austiz/Hovercraft/51o7EGVD7rL._SX522_.jpg

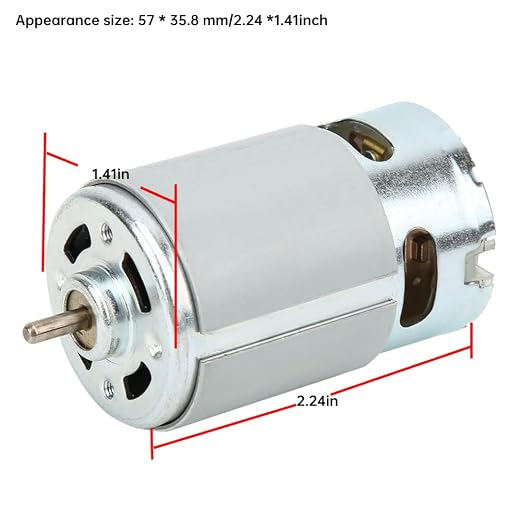
51o7EGVD7rL._SX522_.jpg
