austiz/Hovercraft/mockup/05_fan_closeup.png

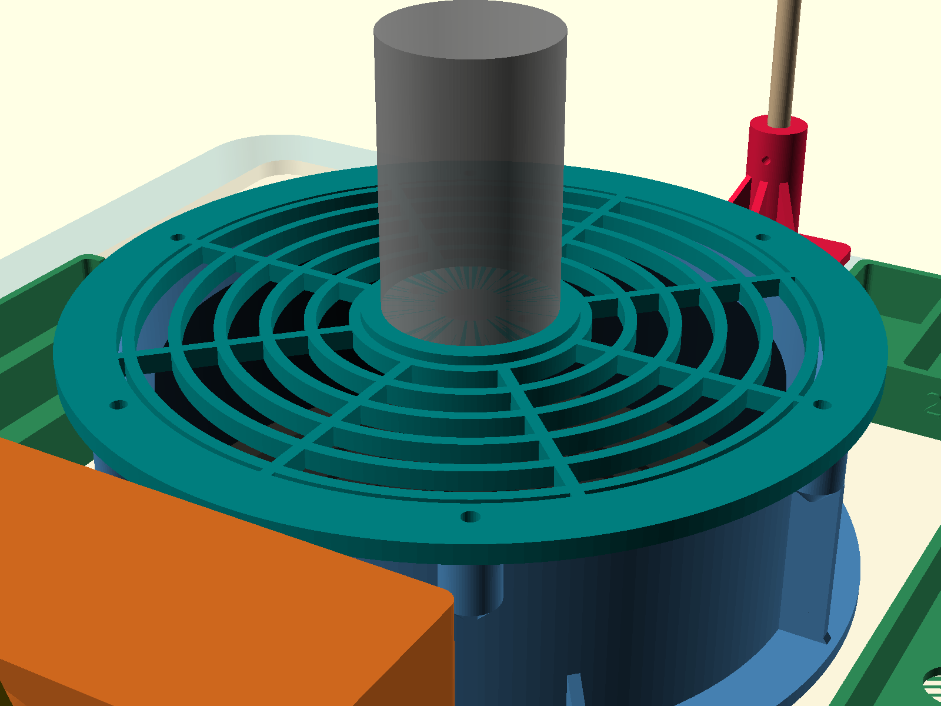
mockup/05_fan_closeup.png
