austiz/Hovercraft/mockup/01_iso_front.png

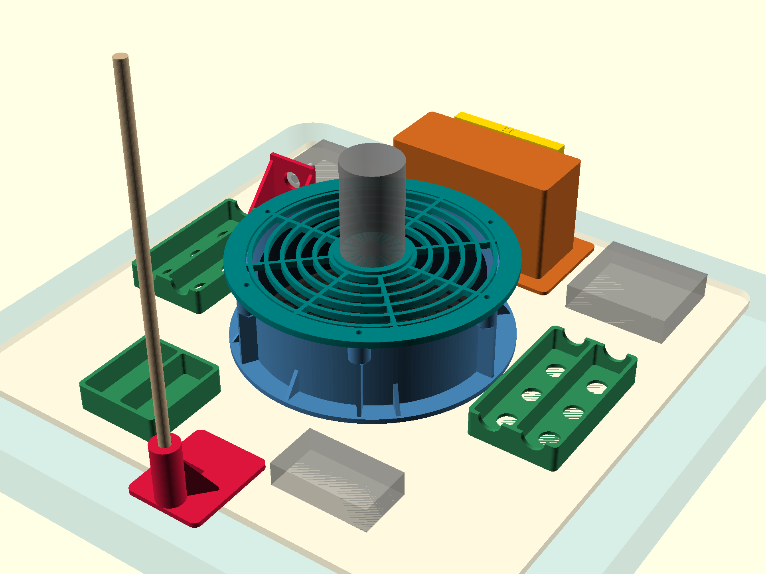
mockup/01_iso_front.png
