austiz/Hovercraft/mockup/02_iso_rear.png

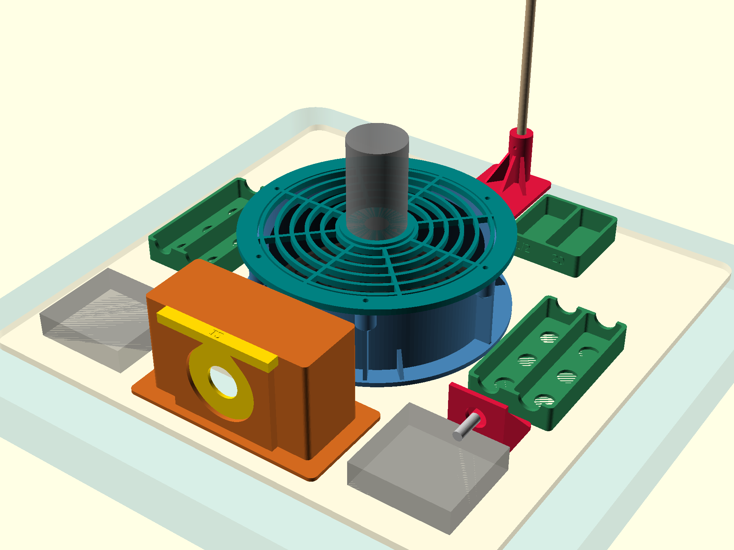
mockup/02_iso_rear.png
