austiz/Hovercraft/mockup/03_top.png

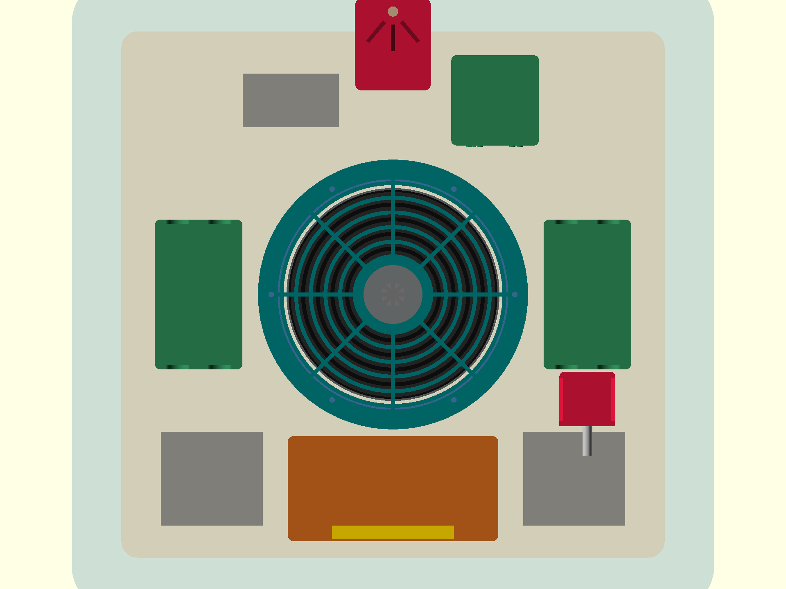
mockup/03_top.png
