austiz/Hovercraft/mockup/04_side.png

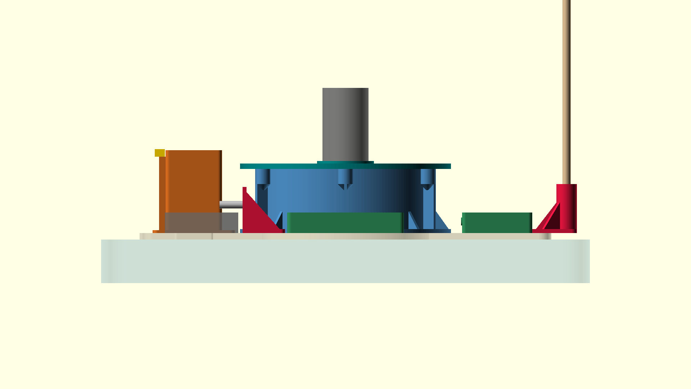
mockup/04_side.png
