austiz/Hovercraft/mockup/06_nozzle_closeup.png

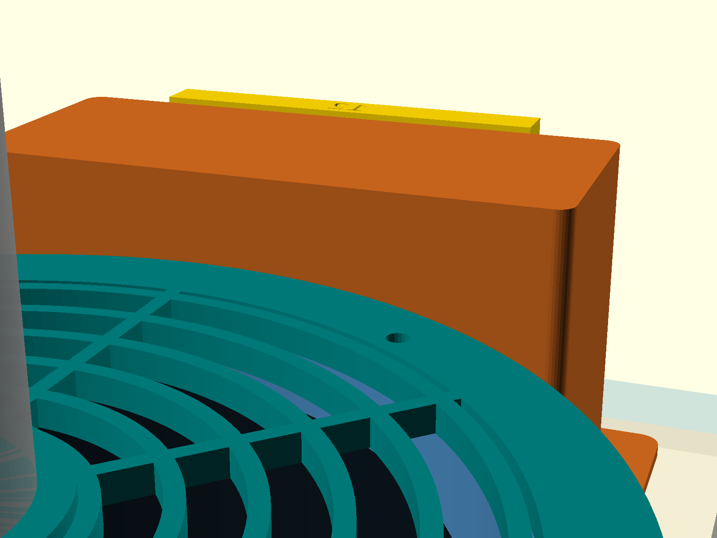
mockup/06_nozzle_closeup.png
