austiz/Hovercraft/mockup/07_underside.png

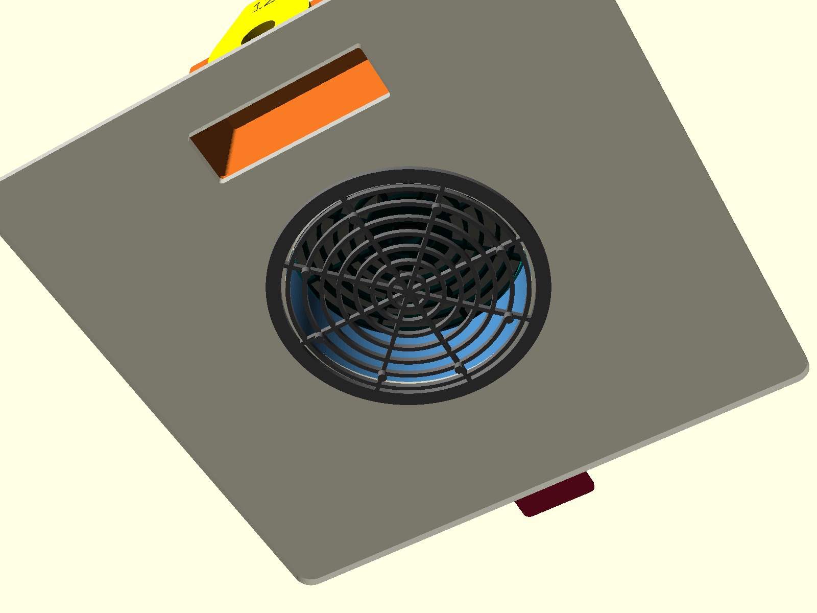
mockup/07_underside.png
