austiz/Hovercraft/stl/mockup_assembly.stl

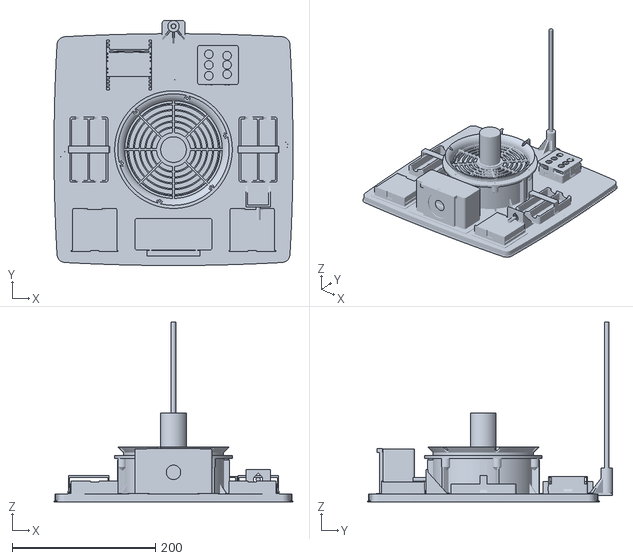
[picture p9: CAD file, 2026-10-20]
stl/mockup_assembly.stl
333.2 x 341.6 x 250.8
