austiz/Hovercraft/stl/deck_bl.stl

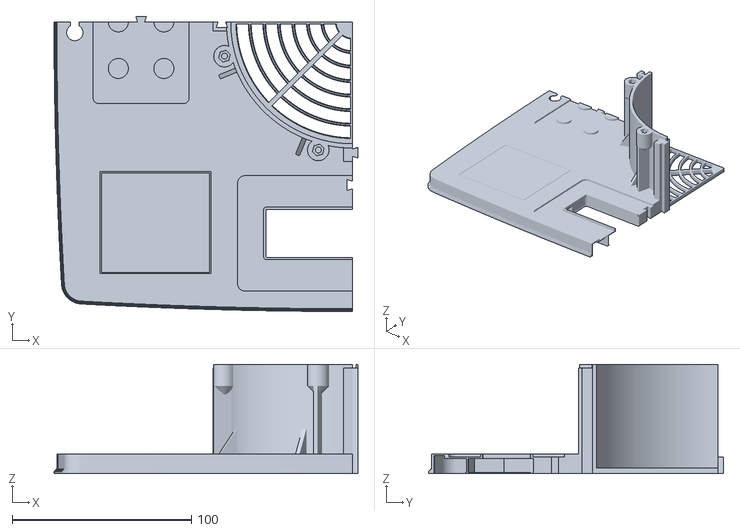
[picture p10: CAD file, 2026-10-20]
stl/deck_bl.stl
169.6 x 164.6 x 60.8
