austiz/Hovercraft/stl/v1/plate_test.stl

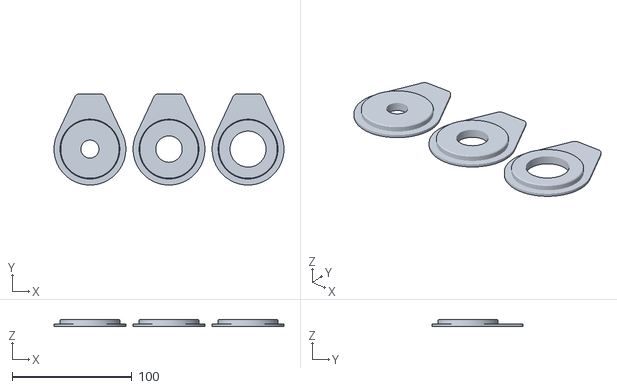
[picture p11: CAD file, 2026-10-09]
stl/v1/plate_test.stl
192.0 x 76.0 x 6.00
