austiz/Hovercraft/stl/bdeck_fl.stl

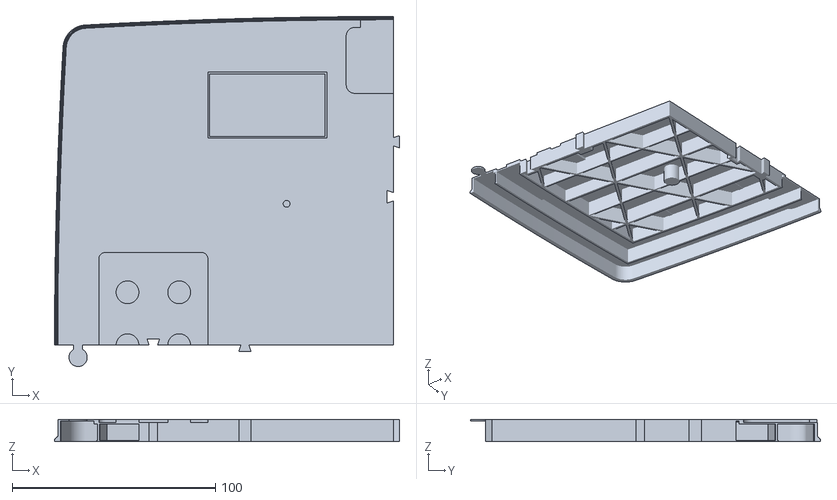
[picture p12: CAD file, 2026-10-20]
stl/bdeck_fl.stl
169.6 x 172.1 x 10.8
