austiz/Hovercraft/stl/v1/rack_aux.stl

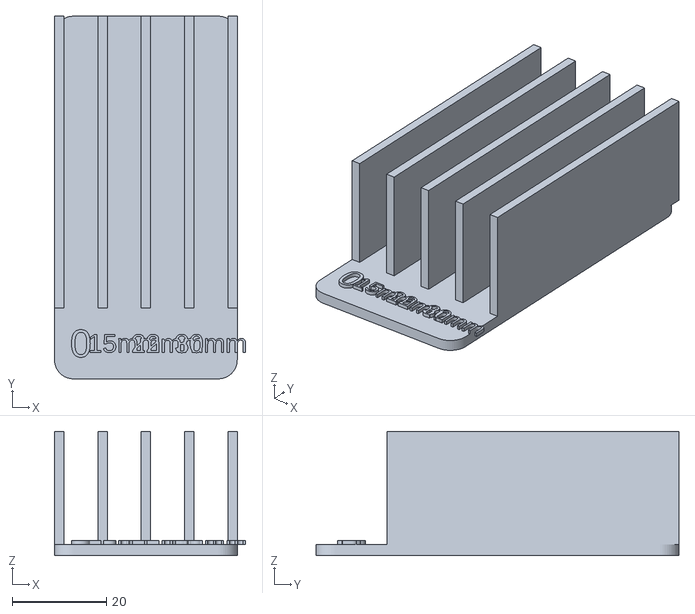
[picture p13: CAD file, 2026-10-09]
stl/v1/rack_aux.stl
40.6 x 77.0 x 26.4
