austiz/Hovercraft/stl/deck_fr.stl

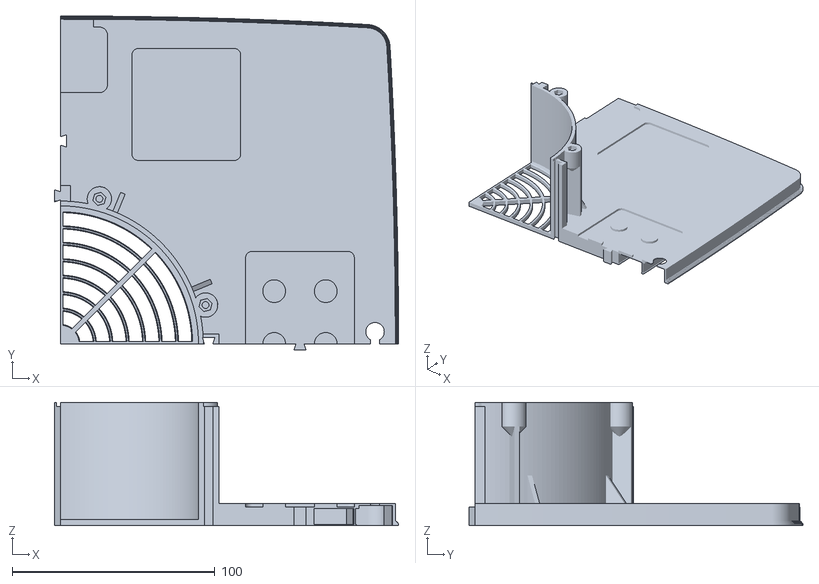
[picture p14: CAD file, 2026-10-20]
stl/deck_fr.stl
169.6 x 164.6 x 60.8
