austiz/Hovercraft/stl/v1/plate_rack.stl

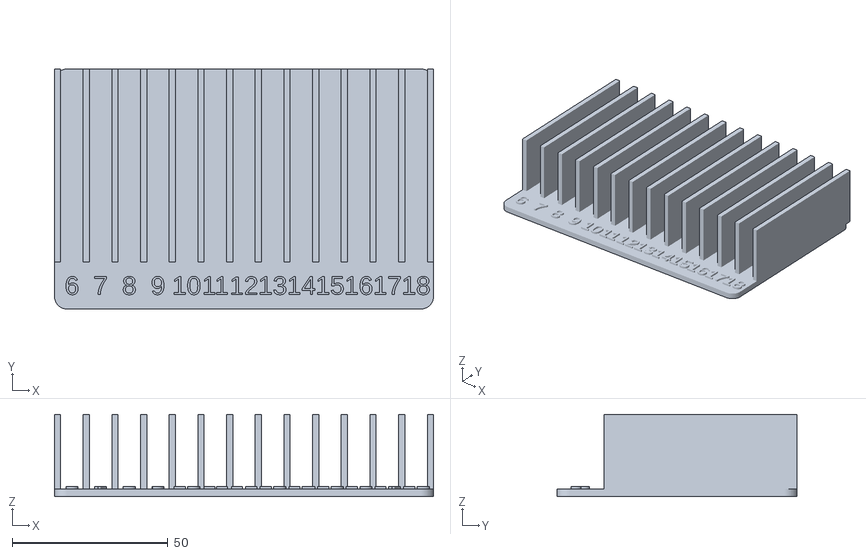
[picture p15: CAD file, 2026-10-09]
stl/v1/plate_rack.stl
121.6 x 77.0 x 26.4
