austiz/Hovercraft/stl/deck_fl.stl

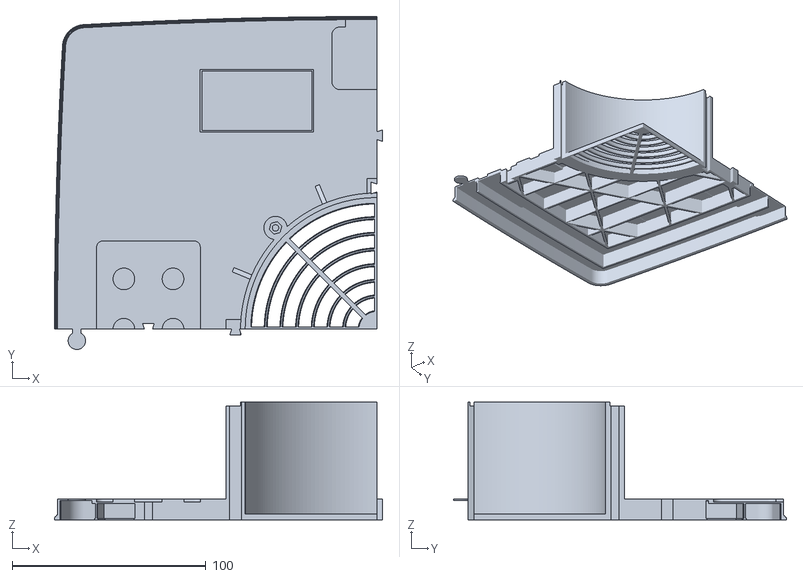
[picture p16: CAD file, 2026-10-20]
stl/deck_fl.stl
169.6 x 172.1 x 60.8
