austiz/Hovercraft/stl/v1/nozzle.stl

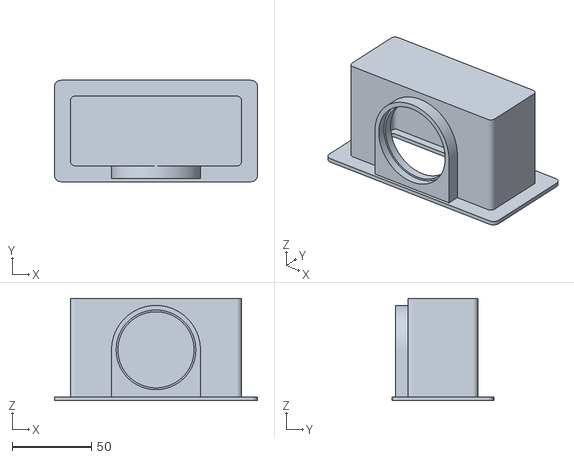
[picture p17: CAD file, 2026-10-09]
stl/v1/nozzle.stl
128.0 x 64.0 x 64.4
