austiz/Hovercraft/stl/deck_fit_test.stl

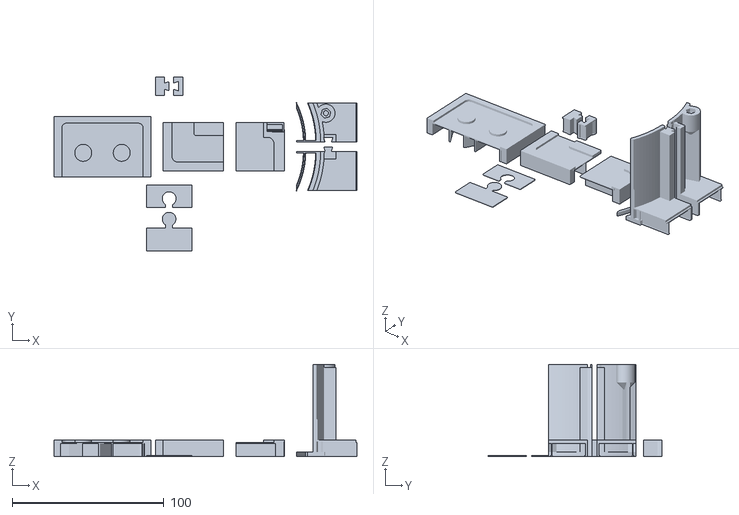
[picture p18: CAD file, 2026-10-20]
stl/deck_fit_test.stl
200.0 x 114.8 x 60.8
