austiz/Hovercraft/stl/v1/plate_zero.stl

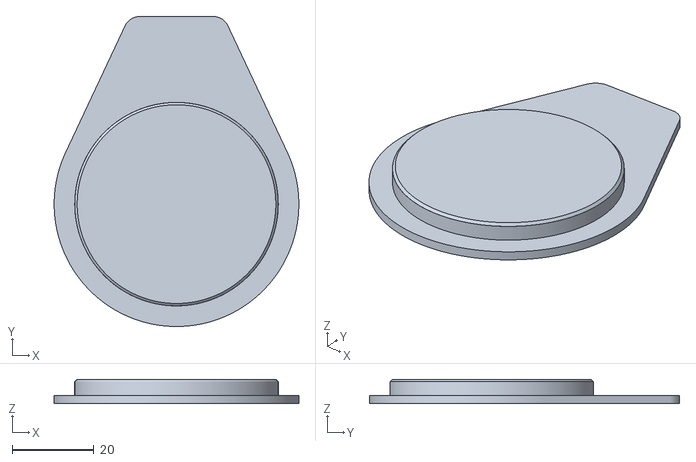
[picture p19: CAD file, 2026-10-09]
stl/v1/plate_zero.stl
60.0 x 76.0 x 6.00
