austiz/Hovercraft/stl/bdeck_fr.stl

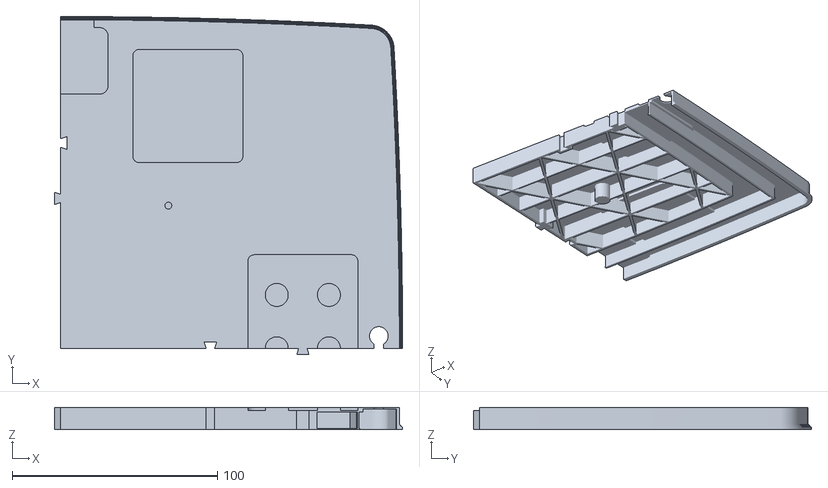
[picture p20: CAD file, 2026-10-20]
stl/bdeck_fr.stl
169.6 x 164.6 x 10.8
