austiz/Hovercraft/stl/v1/plates.stl

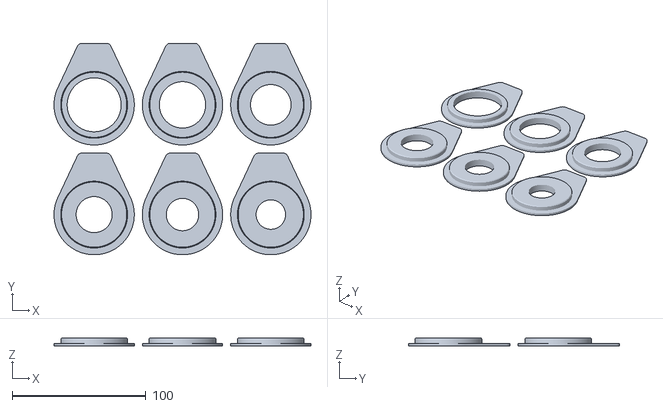
[picture p21: CAD file, 2026-10-09]
stl/v1/plates.stl
192.0 x 158.0 x 6.00
