austiz/Hovercraft/stl/blower_box.stl

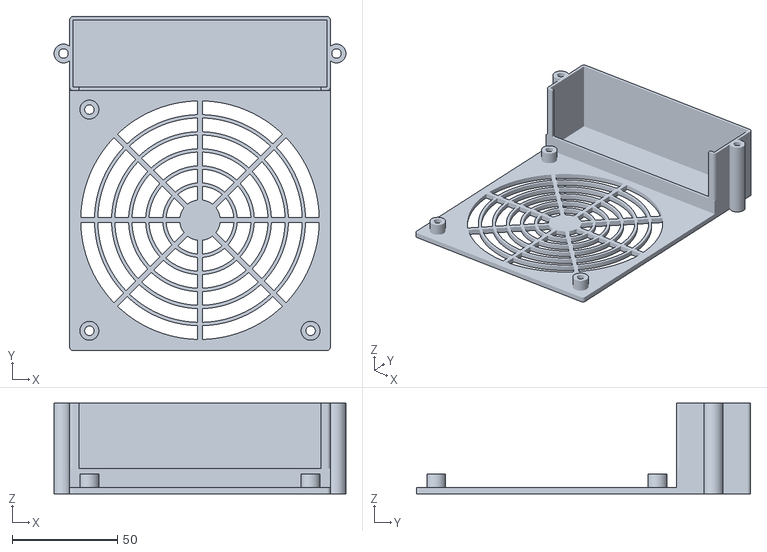
[picture p22: CAD file, 2026-10-20]
stl/blower_box.stl
138.6 x 158.6 x 43.0
