austiz/Hovercraft/stl/bdeck_bl.stl

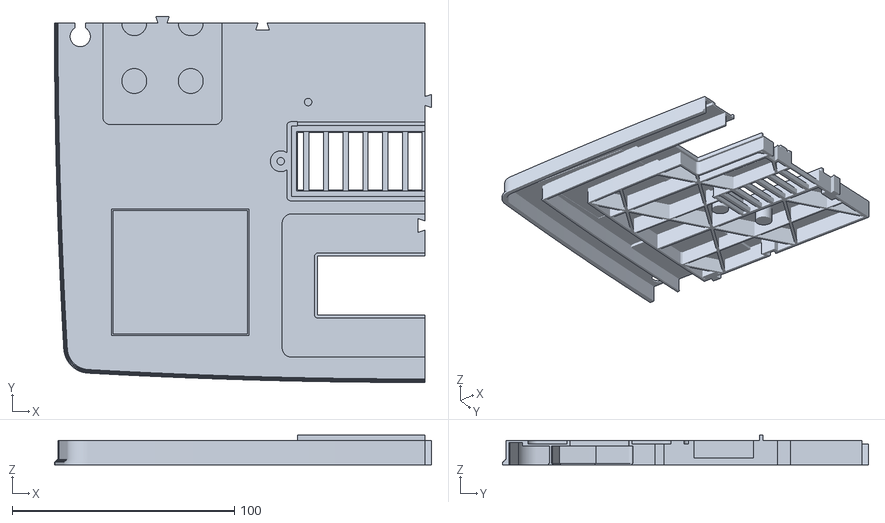
[picture p23: CAD file, 2026-10-20]
stl/bdeck_bl.stl
169.6 x 164.6 x 13.3
