austiz/Hovercraft/stl/bdeck_br.stl

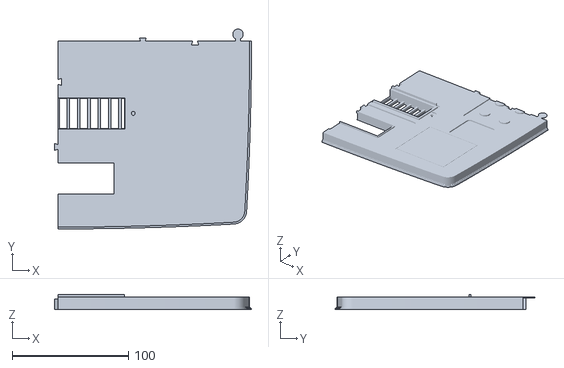
[picture p24: CAD file, 2026-10-20]
stl/bdeck_br.stl
169.6 x 172.1 x 13.3
