austiz/Hovercraft/stl/deck_br.stl

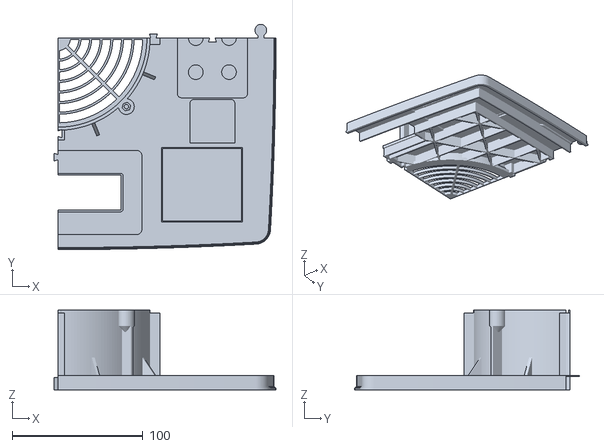
[picture p25: CAD file, 2026-10-20]
stl/deck_br.stl
169.6 x 172.1 x 60.8
