austiz/Hovercraft/stl/plate_rack.stl

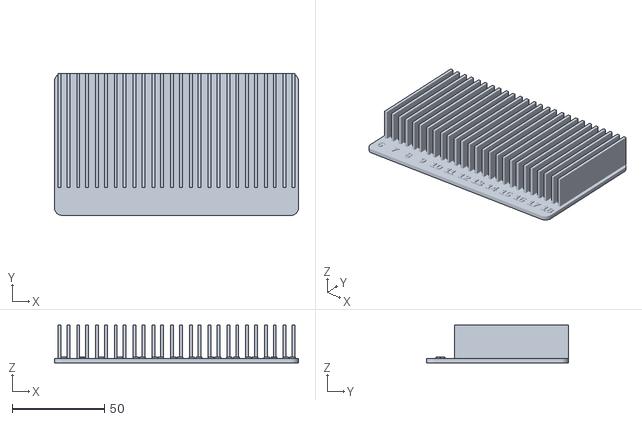
[picture p26: CAD file, 2026-10-09]
stl/plate_rack.stl
132.6 x 77.0 x 20.4
