austiz/Hovercraft/stl/coin_bin.stl

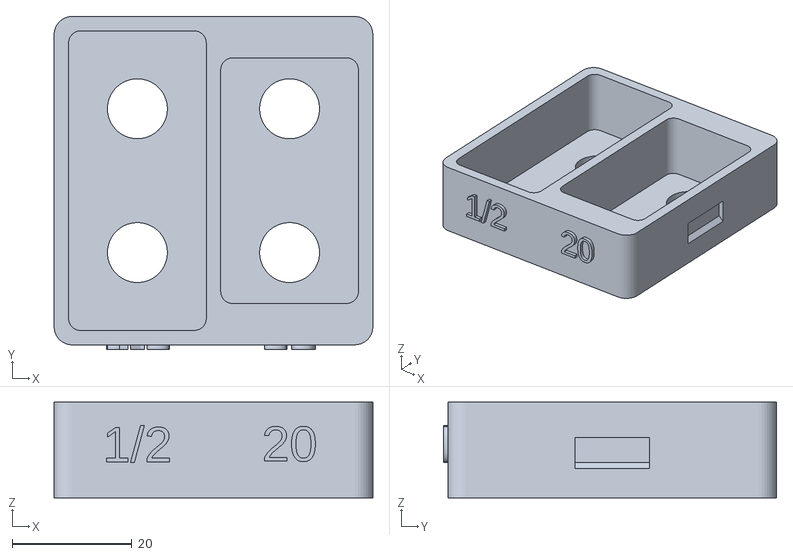
[picture p27: CAD file, 2026-10-09]
stl/coin_bin.stl
53.2 x 55.6 x 16.0
