austiz/Hovercraft/stl/plate_zero.stl

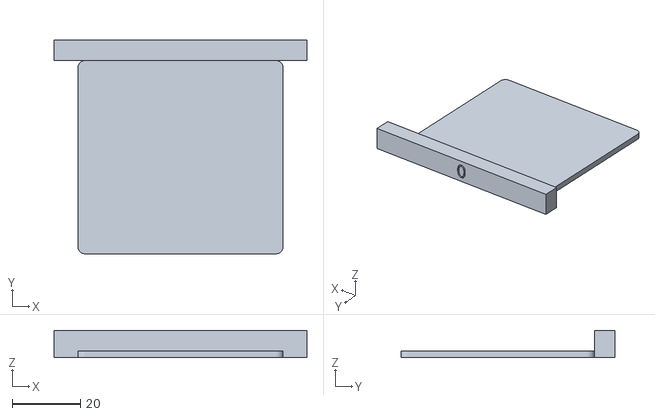
[picture p28: CAD file, 2026-10-09]
stl/plate_zero.stl
74.0 x 62.5 x 8.00
