austiz/Hovercraft/stl/aa2_fences.stl

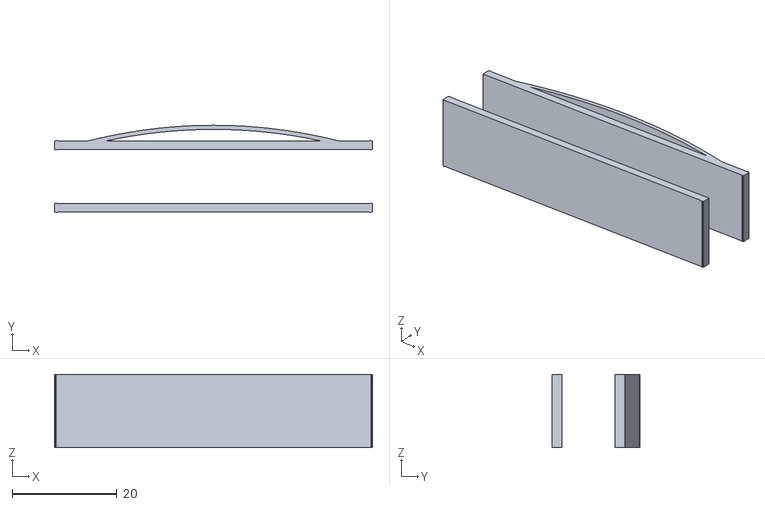
[picture p29: CAD file, 2026-10-09]
stl/aa2_fences.stl
60.8 x 16.7 x 14.0
