austiz/Hovercraft/stl/chart_plate.stl

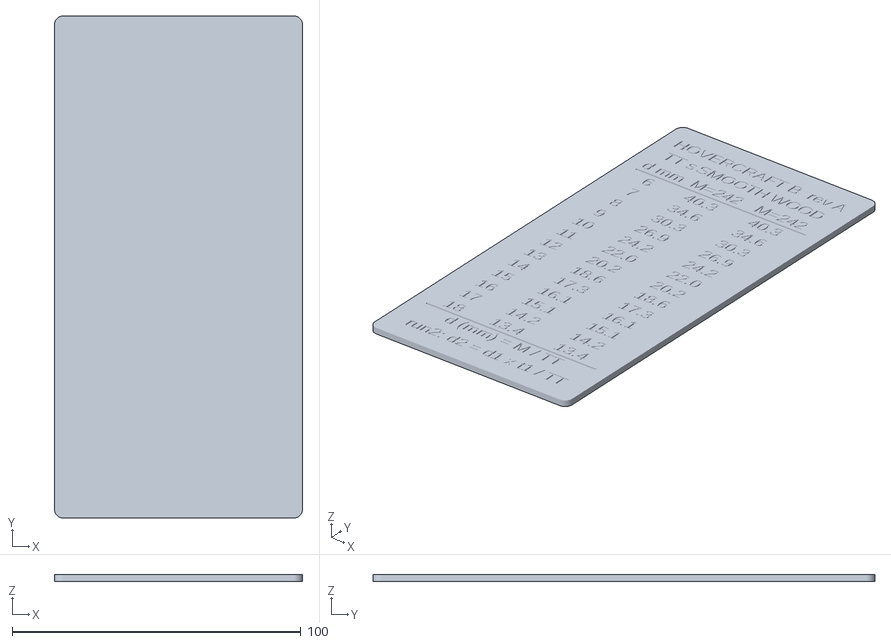
[picture p30: CAD file, 2026-10-09]
stl/chart_plate.stl
86.0 x 174.0 x 2.40
