austiz/Hovercraft/stl/wire_clips.stl

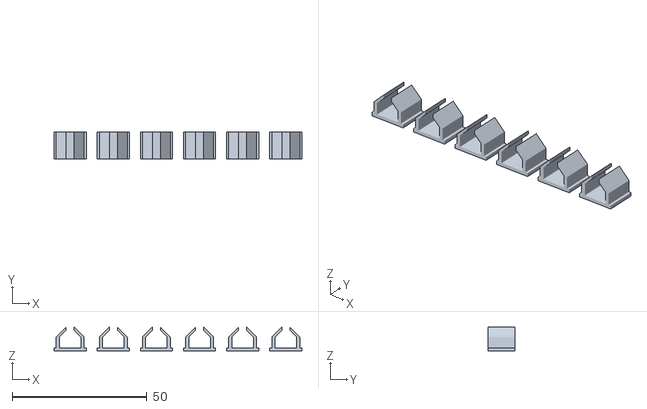
[picture p31: CAD file, 2026-10-09]
stl/wire_clips.stl
92.0 x 10.0 x 8.90
