austiz/Hovercraft/stl/nozzle.stl

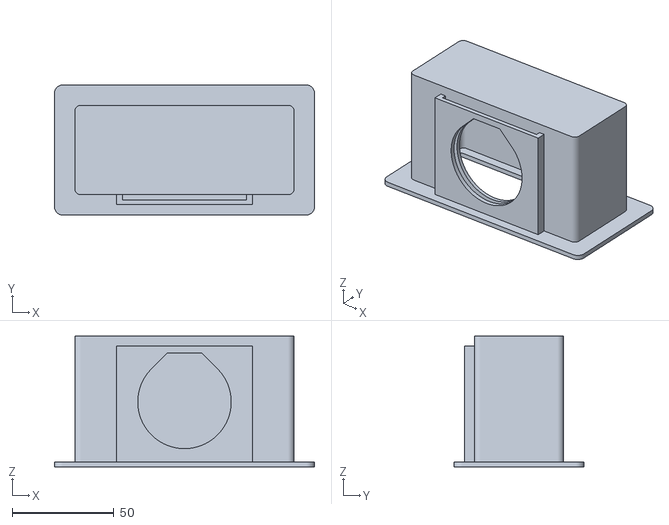
[picture p32: CAD file, 2026-10-09]
stl/nozzle.stl
128.0 x 64.0 x 64.4
