austiz/Hovercraft/stl/rack_aux.stl

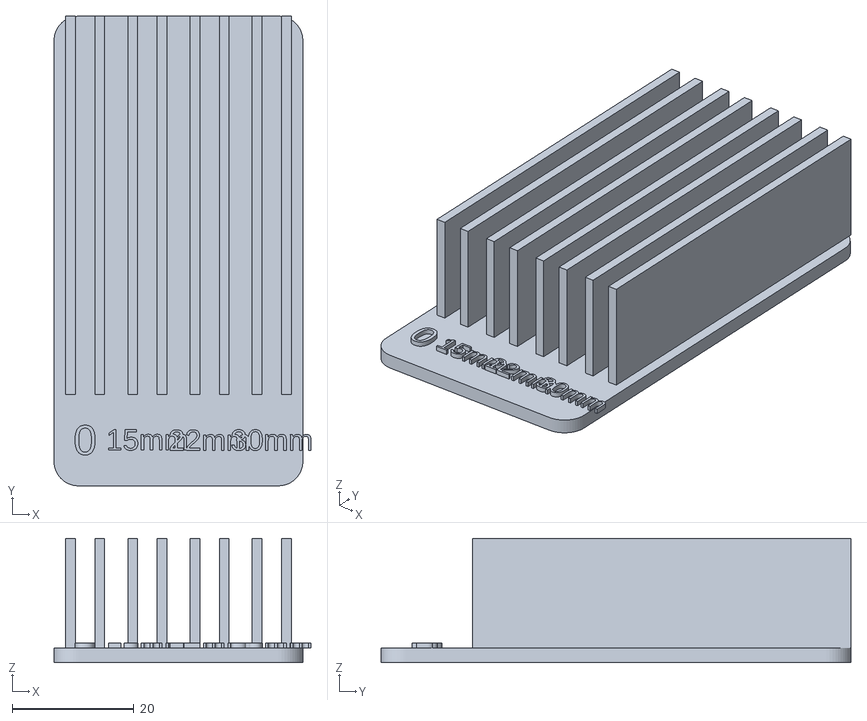
[picture p33: CAD file, 2026-10-09]
stl/rack_aux.stl
42.1 x 77.0 x 20.4
