austiz/Hovercraft/stl/fan_cage_hs390.stl

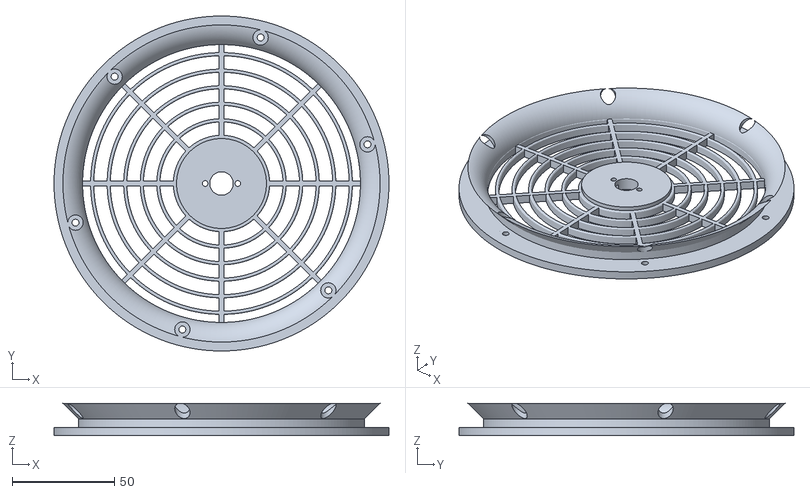
[picture p34: CAD file, 2026-10-09]
stl/fan_cage_hs390.stl
164.0 x 164.0 x 15.7
