austiz/Hovercraft/stl/aa4_mount.stl

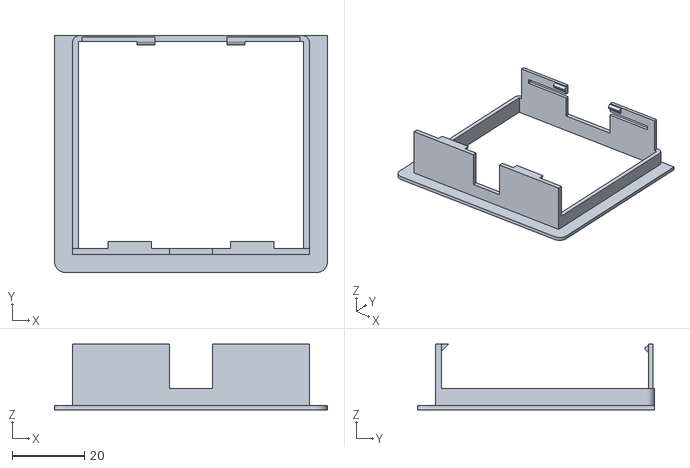
[picture p35: CAD file, 2026-10-09]
stl/aa4_mount.stl
75.8 x 65.8 x 18.3
