austiz/Hovercraft/stl/wear_pad.stl

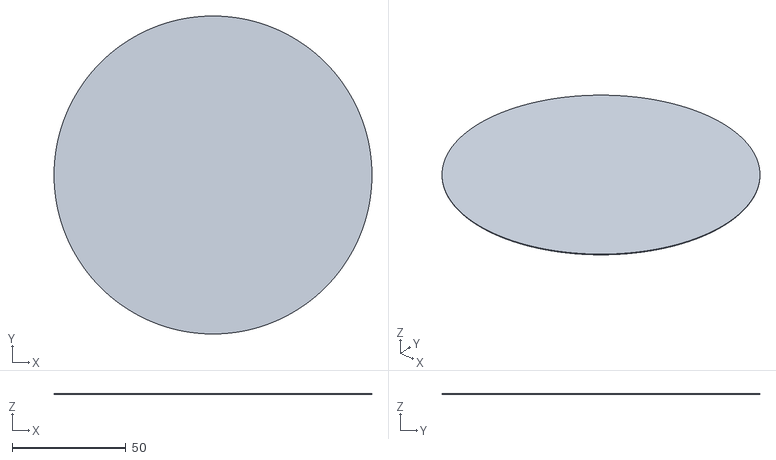
[picture p36: CAD file, 2026-10-09]
stl/wear_pad.stl
140.0 x 140.0 x 0.48
