austiz/Hovercraft/stl/tray_bar.stl

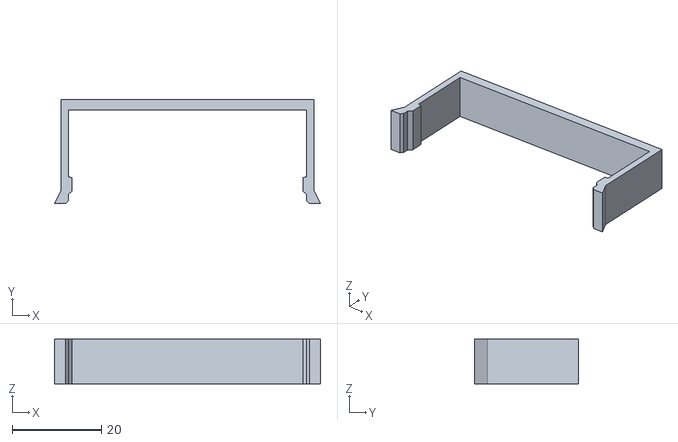
[picture p37: CAD file, 2026-10-09]
stl/tray_bar.stl
59.7 x 23.4 x 10.0
