austiz/Hovercraft/stl/plate_test.stl

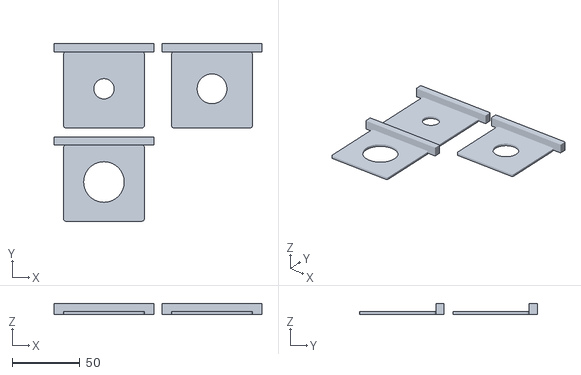
[picture p38: CAD file, 2026-10-09]
stl/plate_test.stl
154.0 x 131.5 x 8.00
