austiz/Hovercraft/stl/aa2_tray.stl

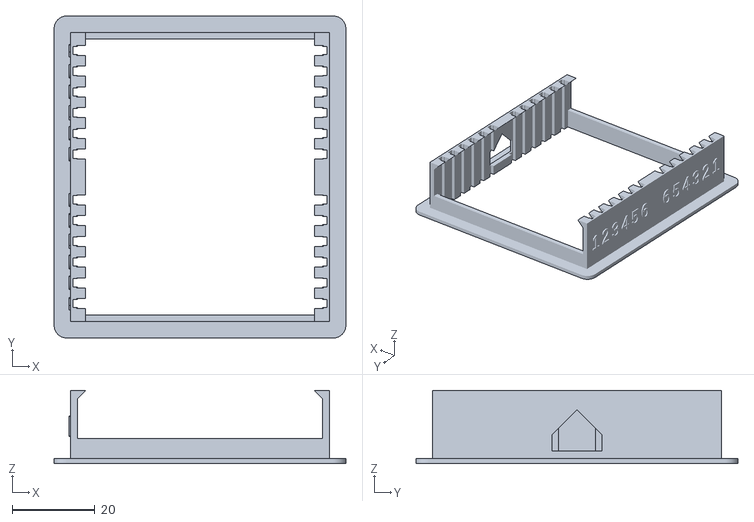
[picture p39: CAD file, 2026-10-09]
stl/aa2_tray.stl
70.3 x 77.6 x 17.6
