austiz/Hovercraft/stl/templates.stl

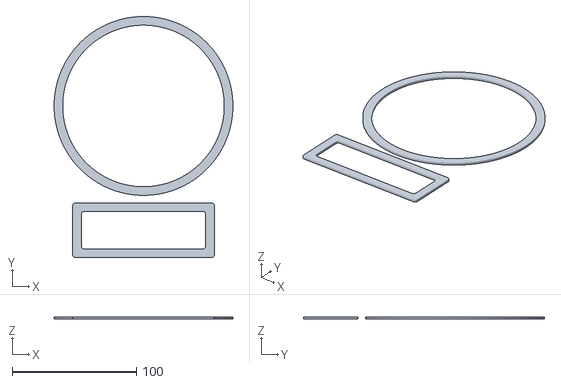
[picture p40: CAD file, 2026-10-09]
stl/templates.stl
144.0 x 194.0 x 2.00
