austiz/Hovercraft/stl/nickel_tray.stl

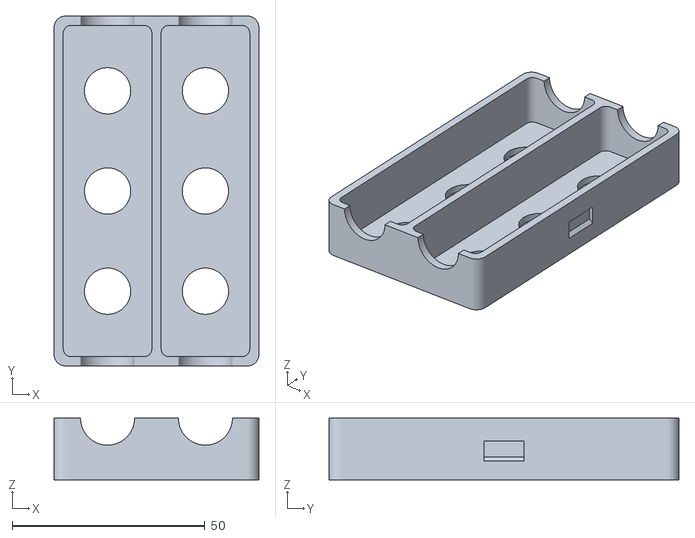
[picture p41: CAD file, 2026-10-09]
stl/nickel_tray.stl
53.2 x 90.8 x 16.0
