austiz/Hovercraft/stl/bin_lid.stl

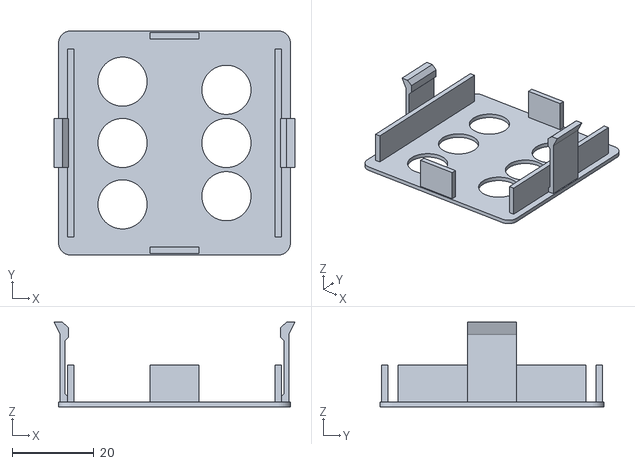
[picture p42: CAD file, 2026-10-09]
stl/bin_lid.stl
58.9 x 54.8 x 20.7
