austiz/Hovercraft/stl/stick_stand.stl

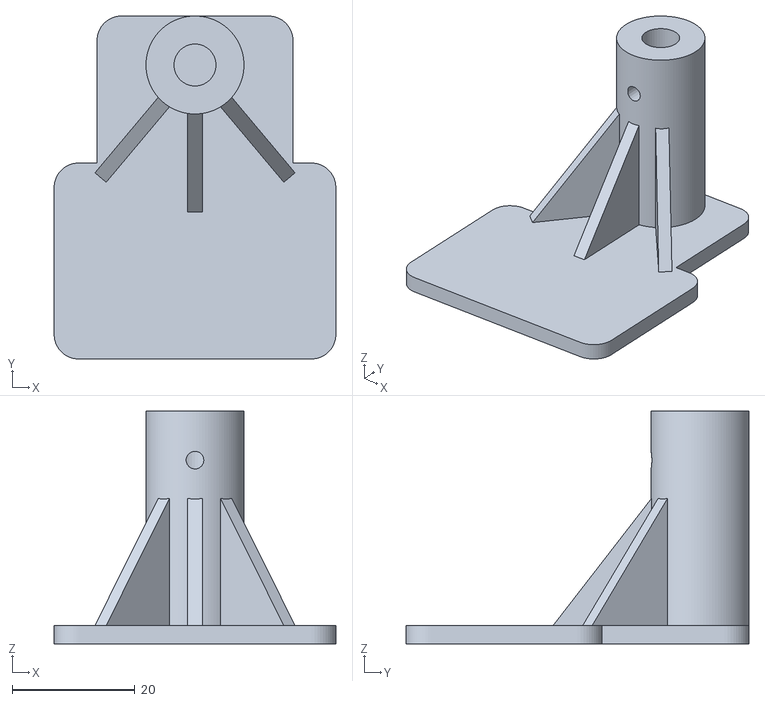
[picture p43: CAD file, 2026-10-09]
stl/stick_stand.stl
46.0 x 56.0 x 38.0
