austiz/Hovercraft/stl/switch_bracket.stl

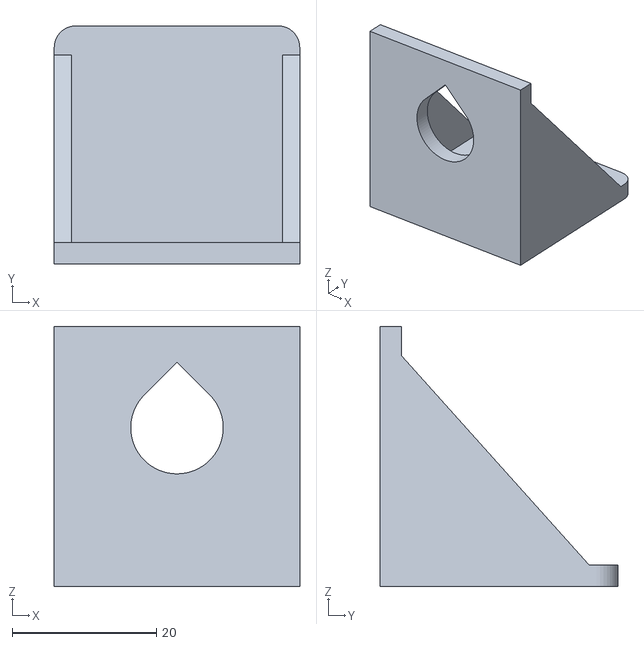
[picture p44: CAD file, 2026-10-09]
stl/switch_bracket.stl
34.0 x 33.0 x 36.0
