austiz/Hovercraft/stl/plates.stl

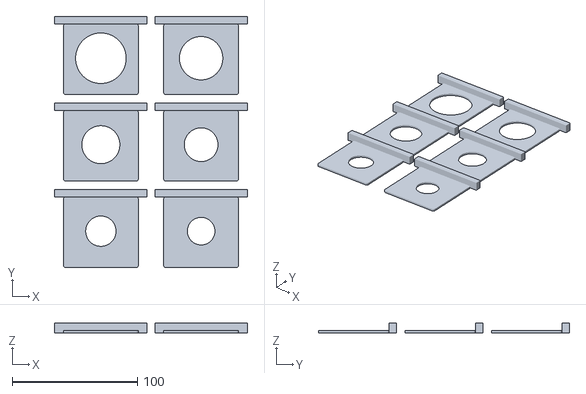
[picture p45: CAD file, 2026-10-09]
stl/plates.stl
154.0 x 200.5 x 8.00
