austiz/Hovercraft/hovercraft_parts.scad

/* ============================================================================
   HOVER RACER — 3D PRINTABLE PARTS
   Science Olympiad Hovercraft B, 2027 rules
   Companion file to "Hover Racer Workshop.html"

   Every printed part named in the workshop lives in this one file.  Pick a part
   with the PART variable below, press F5 to look at it, F6 to render, then
   File > Export > Export as STL.  (export_stl.ps1 next to this file does all of
   them in one go.)

   PART options
   ------------------------------------------------------------------------
     "assembly"     the whole craft, for checking fit.  Not printable.
                    Read the Console: it prints the rule checks.
     "mockup"       the same without the see-through skirt, for exporting
                    as one STL (stl\mockup_assembly.stl) to look at in the
                    slicer or any 3D viewer.  Do NOT print it.
     "fan_tube"     FOAM-BOARD DECK ONLY: the shroud that glues over the
                    12 cm hole.  The printed deck has it built in.
     "fan_cage"     the top guard; the RS-550 bolts straight to its hub.
                    The ring on top is the duct's rounded inlet (bellmouth)
     "fan_cage_hs390"  the same cage with a hub for the HS390 motor instead
     "fan_guard"    FOAM-BOARD DECK ONLY: the guard that glues UNDER the
                    hole.  The printed deck has it built in.
     "nozzle"       the box over the 3 x 10 cm slot with the card guide
                    (NOZZLE_V = 2) or the press-fit socket (NOZZLE_V = 1).
                    "nozzle_v1" / "nozzle_v2" pick one explicitly.
     "plate"        one speed card (or plate for v1)  (set PLATE_TIME)
     "plates"       a batch of them (set PLATE_BATCH)
     "plate_zero"   the no-hole card for the drift test
     "plate_test"   the three calibration cards: 15, 22 and 30 mm
     "plate_rack"   numbered rack that carries the cards to the tournament
     "rack_aux"     4-slot sibling rack: the zero card + the three test cards
     "chart_plate"  engraved calibration chart, one column per surface.
                    Print TWO: charts must be IMPOUNDED to be used (rule 2a)
     "nickel_tray"  two roll slots.  Print TWO of these.
     "tray_bar"     snap-on bridge over a tray's rolls.  Print TWO.
     "coin_bin"     half roll + 20 loose nickels
     "bin_lid"      snap-on windowed lid for the coin bin
     "stick_stand"  socket for the 1/4" timing dowel
     "switch_bracket" panel for the toggle switch (it cannot mount through
                    foam: the nut crushes it and the body hangs in the bag)
     "aa4_mount"    glue-on snap frame for a 4 x AA holder.  Print TWO.
     "aa2_tray"     glue-on sliding trim tray for the 2 x AA holder
     "aa2_fences"   the pair of drop-in fences for that tray
     "wire_clips"   six saddle clips for the 18 AWG wire runs
     "templates"    marking templates for the fan hole and the nozzle slot
     "wear_pad"     the 14 cm foot that is duct-taped to the outside of the
                    bag under the fan (the workshop uses a milk jug)
     "deck_fl" "deck_fr" "deck_bl" "deck_br"
                    OPTIONAL printed deck in four quarters (front-left,
                    front-right, back-left, back-right) that replaces the
                    foam board — with the fan duct and the bottom guard
                    BUILT IN: fan, straight 136 mm duct, guard grid, bag,
                    no glued flange anywhere.  "deck" shows all four put
                    together.  Every part presses into a pocket in it
                    (DECK_SOCKETS); only the fan_cage still bolts on.
     "deck_fit_test" coupons of those pockets, the duct seam (both halves,
                    with its dovetail key) and a jigsaw tab pair.  Print
                    this first and press the real parts in; adjust
                    SOCK_FIT / DT_CLR / DECK_TAB_CLR, then print the
                    quarters.
     "bdeck_fl" "bdeck_fr" "bdeck_bl" "bdeck_br"
                    the same printed deck for a BLOWER instead of the
                    propeller: a Delta BFB1212GH (120 x 120 x 32, 12 V,
                    ~4 A) screwed flat on the deck, blowing sideways into a
                    hood over a guarded port.  No duct: ~13 mm tall.  Only
                    the fan differs; every other pocket is the same.
                    "bdeck" shows all four.  Setting FAN_TYPE to blower
                    puts the blower in "assembly" and "deck" too.
     "blower_box"   the blower's lid: guard roof over its inlet, standoffs
                    on its three screw holes, and the hood that turns its
                    outlet down through the deck.  Prints roof down.

   Hardware to buy (none of it comes with the motor)
   ------------------------------------------------------------------------
     2x M3 x 6 socket head     motor to cage hub.  6 mm, NO LONGER.
     6x M3 x 10 + 6x M3 nut    cage to tube lugs (nuts drop into the lugs)
     1x M3 x 8                 dowel set screw in the stick stand
     Printed deck: NO screws — the quarters lock with dovetails.  Thin
                               CA glue (and gel CA for the bore seams)
                               and clear packing tape for the joints.
     5 ft of 1/8" or 3/16" shock cord (bungee by the foot, any hardware
                               store) + a cord lock   the hem cord of the
                               skirt cap, which snaps over the deck's lip
                               (DECK_LIP).  Cut the skirt plastic 48 x 47 cm:
                               43 x 42 of skirt + a 2 cm hem each side.
     Blower deck instead of the propeller: 5x M4 x 50 (pan or socket
                               head) — three through blower_box and the
                               blower into the deck, two through the hood
                               tubes — and ~40 cm of 3 mm closed-cell foam
                               tape (window/door seal) for the hood frame.
                               No cage, motor, prop or nuts.
     HS390 instead: 2x M2.5 x 5 socket head (M2.6 x 5 if its holes are
                               M2.6, as on the Mabuchi 385), and a
                               2.3 mm collet prop adapter
     4x 6.3 mm female spade crimps   the toggle switch has spade tabs; the
                               lever connectors in the shopping list do
                               not take them
     The MECCANIXITY 5030 props have a 6 mm bore and the adapter is 5 mm:
     use the 5 mm ring from the prop's bag, and glue it if it is loose.

   Print settings  (per-part table in PRINT_SETTINGS.md next to this file)
   ------------------------------------------------------------------------
     Material     PLA.  Parts on the craft are about 330 g at these settings
                  (the deck quarters are the heavy ones, ~65-75 g each,
                  duct included); the whole set with spares and the rack
                  is about 500 g.
     Layers       0.2 mm, 0.4 mm nozzle
     Walls        3 everywhere; fan_cage 4 walls / 40% infill (it carries
                  the motor)
     Infill       15%
     Supports     none for the v2 set.  Only nozzle v1 needs supports
                  (everywhere, or painted on the socket bore and box roof).
     Orientation  every part is already drawn the way it prints.  Do not
                  rotate anything except to fit the bed.

   Build order (printed deck + fan)
   ------------------------------------------------------------------------
     1. Light-test each quarter's skin; tape any pinholes.
     2. Right side up on a flat table: lower front-right onto front-left
        (the dovetails only go in straight down), the same for the back
        pair, then lower the front half onto the back half.  No screws.
        Bolt the bare fan_cage across all four duct tops: it holds the
        duct round while the glue sets.
     3. Wick thin CA into every dovetail outline and seam line from the
        top face, and along the seam ribs underneath.  Run a bead of gel
        CA down each duct seam inside the bore.  Clear tape over the
        joints underneath.  Take the cage off again.
     4. Bolt the motor to the fan_cage hub from UNDERNEATH with two M3 x 6
        screws.  The heads sit in counterbores, flush with the cage.
        Longer screws reach the windings inside the motor: 6 mm, no more.
     5. Push the adapter and propeller onto the shaft, under the cage.
     6. Drop an M3 nut into the pocket on top of each lug, lower the cage
        (with motor and prop) on, 6x M3 x 10 from above, through the six
        holes in the bellmouth ring (a 2.5 mm hex key, 15 mm+ shank).
     The propeller is larger than the duct bore, so it can only go in from
     above with the cage off.  This order is not optional.
     (Foam-board deck instead: glue fan_tube over the hole and fan_guard
     under it, airtight all the way round both flanges, then 4-6.)

   Build order (blower deck: bdeck_* + blower_box)
   ------------------------------------------------------------------------
     1-3. As above, with the bdeck quarters (no duct seams, no cage).
     4. Stick 3 mm foam tape on blower_box's frame: both posts, the strip
        over the window and the deck's sill, the face that meets the
        blower's outlet side.
     5. Stand the blower label-side down on the deck, outlet towards the
        back, its three holes over the three pilot holes, wires out the
        front.  Lower blower_box on: hood walls into their grooves,
        standoffs on the blower's holes.
     6. 5x M4 x 50 from the top, snug, not tight (they self-tap PLA).
     7. Blue wire (PWM) left open = full speed.  CHECK THIS ON THE BENCH:
        some 4-wire fans idle with PWM open (ENGINEERING_CHECK 8.7).
        Do NOT tie blue to the 12 V wire.
     Cut only TWO 24 mm holes in the skirt, not six (ENGINEERING_CHECK
     section 8.7): the blower makes pressure, not flow.

   WHY THE MOTOR BOLTS STRAIGHT TO THE CAGE: an RS-550 shaft only sticks out
   7.5 to 12.5 mm.  Any plate between motor and cage lifts the propeller
   into the cage.  Measure PROP_DROP on your own motor before printing.

   SAFETY: cage and guard openings are GRID_OPEN mm wide.  The rules say a
   9.5 mm (3/8") dowel must not reach the blades, and the workshop says
   test with a pencil (~7 mm).  Do not raise GRID_OPEN above 7.

   RULE 3a: the craft must fit a 40 x 40 x 40 cm box WHILE FLOATING, skirt
   and all.  The workshop's 36 x 34 cm deck is too big once the skirt puffs
   out.  DECK_X / DECK_Y below are what to cut instead; cut the skirt
   plastic 10 cm bigger than the deck each way, as the workshop says.
   The fan hole is 13 cm, not 12 (see DECK_HOLE_D).  Print "templates" and
   trace them rather than measuring: they follow these numbers.

   The maths behind all of this is in ENGINEERING_CHECK.md next to this file.
============================================================================ */


// ---------------------------------------------------------------- what to show
PART = "assembly";
FAN_TYPE = "prop";    // "prop" or "blower": the fan "assembly" and "deck"
                      // show.  The bdeck_* parts and blower_box are always
                      // the blower, whatever this says
BLOWER = FAN_TYPE == "blower"
      || PART == "bdeck_fl" || PART == "bdeck_fr" || PART == "bdeck_bl"
      || PART == "bdeck_br" || PART == "bdeck"    || PART == "blower_box";

PLATE_TIME  = 12;                       // for PART = "plate"
PLATE_BATCH = [6, 7, 8, 9, 10, 11];     // for PART = "plates"
MAGIC       = 242;                      // YOUR craft's magic number, step 8c
                                        // hole size (mm) = MAGIC / target time


// ---------------------------------------------------------------- quality
$fa  = 2;
$fs  = 0.5;
EPS  = 0.02;

// ---------------------------------------------------------------- hardware
M3_CLEAR = 3.4;     // M3 passes through (vertical printed hole)
M3_SNUG  = 3.3;     // M3 located by the hole
M3_TAP   = 2.6;     // M3 self-taps into PLA (vertical hole)
M3_TAP_H = 2.9;     // M3 self-tap, HORIZONTAL printed hole: prints 0.3-0.4
                    // small, lands at ~2.6 effective = normal tap fit
M3_HEAD_D= 6.5;     // counterbore for an M3 socket head (5.5 mm)
M3_HEAD_H= 3;
M4_CLEAR = 4.5;     // M4 passes through (vertical printed hole)
M4_TAP   = 3.4;     // M4 self-taps into PLA (vertical hole), as M3_TAP

// ---------------------------------------------------------------- the deck
// Foam board, 12 cm fan hole, 3 x 10 cm nozzle slot.
// +Y is the FRONT (the end that crosses the timing beams first).
DECK_X      = 330;    // 33 x 32 cm, NOT the workshop's 36 x 34: see RULE 3a
DECK_Y      = 320;
DECK_T      = 5;
SKIRT_OVER  = 30;     // how far the inflated skirt sticks out past the deck,
                      // each side.  Measure yours while it floats.
DECK_HOLE_D = 130;    // 13 cm, not the workshop's 12: the 127 mm propeller
                      // overhangs a 12 cm hole by 3.5 mm all round and its
                      // tips, which do most of the work, blow onto foam
SLOT_X      = 100;    // slot, left to right
SLOT_Y      = 30;     // slot, front to back
SLOT_BACK   = 42;     // slot centre, this far forward of the back edge

// ---------------------------------------------------------------- printed deck
// Optional replacement for the foam board: four quarters, each fits the P1S
// bed.  A thin skin (the deck's top face, printed on the bed) with a
// triangle grid of ribs underneath, like an aircraft panel.  See PART 11.
DECK_PRINTED = true;  // assembly preview: show the printed deck, not foam
DECK_SKIN   = 0.84;   // 3 layers of 0.28.  The quarters print top face UP
                      // (the fan duct rises out of them), so the skin is
                      // BRIDGED over the rib cells the way the pocket
                      // floors always were: a bridge plus two layers to
                      // close it (the SOCK_FLOOR rule).  Light-test it.
DECK_RIB_H  = 10;     // grid ribs, below the skin, all the way to the bed
                      // plane (the lip bottom): they print from the bed up
                      // and carry the bridged skin
DECK_RIB_W  = 0.9;    // two 0.45 lines
DECK_RIB_FOOT = 0.4;  // extra width per side on the ribs' first 0.6 mm, a
                      // foot that keeps a 10 mm tall 0.9 mm wall on the bed
DECK_CELL   = 55;     // triangle side of the grid
DECK_HALF_RIB_W = 0.45; // half-ribs: one line, along X through the middle of
                      // every cell (bed to skin, with feet).  The skin's
                      // longest bridge in a cell drops from ~46 to ~24 mm
DECK_BAND   = 40;     // band round the edge, outside the grid (the jigsaw
                      // tabs sit in it).  The skirt cap only needs the lip
DECK_BAND_RING = DECK_BAND / 2; // a DECK_RIB_W rib ring this far in from the
                      // edge, so the band's skin bridges ~19 mm, not ~39.
                      // 0 = none
DECK_BAND_SKIN = 0.84;// the band: 3 layers like the skin
DECK_SEAM_W = 1.6;    // seam ribs, one each side of every joint, glued
DECK_SEAM_H = 10;     // back to back; to the bed plane like the grid ribs.
                      // The dovetail keys (DT_*, fan section) hold them.
DECK_TAB_D  = 9;      // jigsaw tabs that lock the skin across the joints
DECK_TAB_CLR= 0.05;   // knob and slot now print as TOP-surface features on
                      // bridged skin (no elephant's foot), so they run
                      // loose.  Fit test 2026-10-08 at 0.2: went together
                      // well but a little XY play; at 0.15 still loose,
                      // so 0.05 (as tight as a printed slip fit goes)
DECK_MARKS  = true;   // engraved outlines showing where each part glues on
DECK_MARK_D = 0.28;   // one layer, recessed into the top surface
DECK_MARK_W = 0.8;    // a strip under each mark keeps 3 full layers
DECK_MARK_PAD = 1.2;  // under the line, this far either side of it

// ---------------------------------------------------------------- deck sockets
// Every printed part presses into a pocket in the deck's top face (the fan
// guard into one underneath), so nothing is marked out or held by glue
// alone, and the parts cannot be put on crooked.  Pockets are cut to the
// parts as drawn in this file.  Print "deck_fit_test" first: it is three
// small coupons to press the real parts into before printing the quarters.
// Printing rule behind all of this: the deck prints top face UP, so the
// pockets are ordinary top-surface recesses — their floors print over the
// pads' bridged undersides and come out solid.  The pads' UNDERSIDES are
// the bridges now (2.3 mm below the skin, spans up to ~33 mm inside the
// rib cells), which the P1S does without help.
DECK_SOCKETS = true;
SOCK_D      = 1.5;    // pocket depth: half the thinnest flange (nozzle, 2.4)
SOCK_FIT    = 0.2;    // per side.  The pocket walls now start on bridged
                      // layers instead of the bed: no elephant's foot, so
                      // fits run LOOSE, not tight.  Expect ~0.1 after the
                      // fit test.  Tight: 0.1.  Drop-in: 0.35.
SOCK_RIM    = 2.4;    // solid rim round each pocket, flush with the deck top
SOCK_FLOOR  = 0.84;   // pad thickness below the pockets: 3 layers of 0.28,
                      // the first of them a bridge (underside), two more
                      // over it to close.  Same rule as the main skin.
SOCK_LIP    = 1.35;   // lip round the nozzle slot that the frame bridges to.
                      // It makes the slot 96.7 x 26.7; the cards absorb that.
SOCK_PEG_D  = 11.2;   // pegs through the trays' 12 mm floor holes (print ~11.7)

// skirt tape line: a groove on the underside, one layer deep, where the
// first strip of tape goes (the workshop says 1 cm in from the edge).  It
// breaks where a socket pad or a jigsaw tab is in the way.  LEGACY: only
// drawn when DECK_LIP is off — on the top-face-up print the band's
// underside is a bridge and a 0.28 mm relief there comes out as mush; the
// lip + shock cord is the skirt attachment now.
DECK_TAPE_IN = 10;
DECK_TAPE_W  = 1.0;
DECK_TAPE_D  = 0.28;

// ---------------------------------------------------------------- wear pad
// The workshop's 14 cm milk-jug circle, printed: flat, 2 layers, edge
// chamfered so the tape lies over it and nothing catches on the track.
// ~10 g against ~5 g of milk jug; durable and slippery.
WEAR_PAD_D  = 140;
WEAR_PAD_T  = 0.48;   // 2 layers: it only has to stay flat and slide
WEAR_PAD_CH = 0.2;    // edge chamfer: the first layer, one step in

// ---------------------------------------------------------------- skirt lip
// A lip round the underside of the edge, like a bucket rim turned down,
// with a ridge at its bottom.  The skirt is a CAP: 1/8" or 3/16" shock cord
// runs in a taped hem round the plastic's edge, like a shower cap or a bowl
// cover.  Stretch it over the lip and the cord snaps in above the ridge; it
// holds the skirt and seals it.  On, or off, in ten seconds, nothing taped.
// The lip also stiffens the edge.
DECK_LIP     = true;
LIP_CROWN    = 5;      // the printed deck's sides bow out: each side's middle
                       // is on DECK_X / DECK_Y, its ends (the corners) 5 mm
                       // in.  A cord round a STRAIGHT side presses on nothing
                       // (pressure = tension / radius), so only the ridge
                       // would hold it there; bowed, a 20 N cord presses
                       // ~7 N/m on every side, about the bag's whole pull.
                       // Rule 3a is unchanged: the middles set the size.
LIP_H        = 10;     // below the band's underside: 3/16" cord + plastic fit
LIP_T        = 1.35;   // 3 lines
LIP_RIDGE    = 1.6;    // ridge at the bottom, outward, past the deck edge
LIP_RIDGE_H  = 1.2;    // ridge height; above it, 45 degree steps back to the wall
LIP_CORD_D   = 4.8;    // hardware-store shock cord: 1/8" (3.2) or 3/16" (4.8),
                       // sold by the foot.  ~1.5 m, plus a cord lock
SKIRT_HEM    = 20;     // plastic folded over the cord to make the hem

// the print bed plane of the top-face-up quarters: the lip bottom.  Rib
// feet, the lip, the duct wall and the guard grid all land on it.
function deck_bed_z() = -(DECK_BAND_SKIN + LIP_H);

// where things sit on the deck: shared by the assembly preview and the
// engraved marks on the printed deck
TRAY_X      = 118;                        // nickel trays at (+/-TRAY_X, 0)
BIN_POS     = [62, DECK_Y / 2 - 42];      // coin bin, front right
AA2_POS     = [-62, DECK_Y / 2 - 42];     // 2 x AA holder, front left
AA4_POS     = [110, -112];                // 4 x AA holders at (+/-x, y)
SW_POS      = [118, -80];                 // switch bracket, panel centre
AA4_SIZE    = [62, 57];
AA4_H       = 16;
AA2_SIZE    = [58.5, 32.4];
AA2_H       = 14.6;

// ---------------------------------------------------------------- the fan
// Motor: RS-550, 12 V, can 35.8 mm, two M3 holes 25 mm apart on the shaft
// face, 3.17 mm shaft.  Propeller: 5030, 127 mm across, on a collet adapter.
PROP_D      = 127;
PROP_DROP   = 10;     // motor face to the TOP of the propeller hub with the
                      // adapter fitted.  MEASURE YOURS.  The blades clear
                      // the cage by PROP_DROP - HUB_T; keep that >= 3 mm.
PROP_HUB_T  = 7;      // preview only
MOTOR_CAN_D = 35.8;
MOTOR_BOLTS = 25;     // spacing of the motor's own two M3 holes
MOTOR_BOSS_D= 14.5;   // clears the ~13 mm centring boss after print shrink
MOTOR_LEN   = 57;     // can length, preview only

TUBE_BORE   = 136;    // 4.5 mm of tip clearance round the propeller
TUBE_WALL   = 2.4;
TUBE_H      = 50;     // deck surface to the top rim
FLANGE_OD   = 164;    // 14 mm of gluing area round the bore
FLANGE_T    = 3;
LUG_N       = 6;      // cage screws
LUG_R       = 74;
LUG_D       = 12;
LUG_H       = 9;      // clearance hole depth
LUG_PHASE   = 15;     // lugs at 15, 75 ... 315 degrees: the duct is split
                      // between the four deck quarters along x = 0 and
                      // y = 0, and no lug may straddle a seam.  The cage
                      // and the legacy fan_tube share this phase.
TUBE_RIB_TOP= 2;      // the duct's seam keys stop this far below the rim
                      // (cage seat)
// dovetail keys: no screws anywhere in the deck.  Every joint is a set of
// VERTICAL dovetails (a tail on one quarter, its socket on the other), so a
// quarter only goes together one way — lowered straight down onto its
// neighbour — and then cannot pull apart sideways.  Each key is a solid
// DT_BLOCK block straddling the joint, bed to skin (to the duct rim on the
// four duct seams), cut by the tail's outline all the way through the skin.
DT_NECK     = 4;      // tail width at the joint line
DT_TIP      = 6;      // tail width at its tip (18 degree flare)
DT_DEPTH    = 3;      // how far the tail reaches across the joint
DT_CLR      = 0.05;   // per side, round the tail.  Vertical walls, so this
                      // is an XY fit: tune it on deck_fit_test's duct pair
                      // (slides down by hand, no wobble; CA wicks the gap).
                      // Fit test 2026-10-08 at 0.2: slid fine, slight XY
                      // wobble; at 0.15 still loose, so 0.05
DT_BLOCK    = [10, 10];             // key block: along the joint, across it
DT_DUCT_R   = TUBE_BORE / 2 + 5;    // duct key centre: its block runs from
                                    // the bore face (68) out to 78
// keys along each joint: [position, owning side].  Joint x = 0 (V) by y,
// joint y = 0 (H) by x.  Owners alternate so every quarter has tails and
// sockets.  +/-DT_DUCT_R are the tall duct keys.  The outer H keys sit in
// the tray pockets, between the pegs; the tray covers them.  The blower
// deck has no duct (all keys deck depth) and its port is where -DT_DUCT_R
// would be, so that key moves under the blower.
DT_KEYS_V   = BLOWER ? [[DT_DUCT_R, 1], [100, -1], [-35, -1], [-91, 1]]
                     : [[DT_DUCT_R, 1], [100, -1], [-DT_DUCT_R, -1], [-91, 1]];
DT_KEYS_H   = [[DT_DUCT_R, -1], [118, 1], [-DT_DUCT_R, 1], [-118, -1]];
NUT_AF      = 5.8;    // M3 nut is 5.5 across flats, 2.4 thick
NUT_T       = 2.6;    // pocket 0.2 deeper than the nut, so the nut always
                      // drops below the cage seat.  That means tightening
                      // pulls the nut UP against the cage and the lug top
                      // carries no preload — so at assembly, bed each nut
                      // on a little epoxy (or wick CA round the flats after
                      // seating, threads kept clean) before the cage goes
                      // on.  Glue the nut, never the screw.

GRID_OPEN   = 6.5;    // every opening in every guard.  Never above 7.
GRID_BAR    = 2.4;    // spoke width.  Also the printed deck's seam bars:
                      // a spoke on each half-axis, 1.2 per quarter
GRID_RING   = 1.6;    // ring width (4 lines).  Thin rings are most of the
                      // open area: 67% open (spokes included) against 63%
GRID_CHAMF  = 0.4;    // 45 deg chamfer on the upstream (top) edge of every
                      // ring, so the air meets a point, not a flat.  Widens
                      // the slot only at the surface; the throat a probe
                      // has to pass stays GRID_OPEN
GRID_SPOKES = 8;      // spokes tying the rings together

CAGE_OD     = 164;    // rim: matches FLANGE_OD, lug holes at LUG_R 74
CAGE_T      = 4;      // rim and rings
CAGE_ZONE   = TUBE_BORE;  // rings live inside this circle.  Not wider:
                          // the rim sits on the duct wall, so a slot past
                          // the bore just blows into the wall
INLET_R     = 12;     // bellmouth on top of the cage rim: radius of the
                      // flare from the bore (r 68) out to r 80.  A sharp
                      // inlet chokes the blade tips; ~0.1 D of radius
                      // gets most of that back.  The prop is only 4 mm
                      // under the cage, so the flare has to be up here.
INLET_T     = 2;      // flare shell thickness (5 lines).  45 deg underside,
                      // open to the outside: no supports, little plastic
INLET_ACC_D = 7.5;    // driver/head access holes through the flare over
                      // the six lug screws (M3 head 5.5)
HUB_OD      = 44;     // solid middle the motor bolts to
HUB_T       = 6;      // 3 mm counterbore + 3 mm under the screw heads.
                      // If measured PROP_DROP <= 9 (blade under 3 mm from
                      // the cage): set 5 and use M3 x 5 motor screws — with
                      // 2 mm under the head an M3 x 6 would reach 4 mm into
                      // the motor, the Mabuchi winding-contact limit

GUARD_OD    = DECK_HOLE_D + 20;   // on the printed deck the 67..75 annulus
                                  // fuses to the skin and is the ring the
                                  // duct lands on; on foam it is glue area
GUARD_T     = 3;
GUARD_ZONE  = DECK_HOLE_D + 4;
GUARD_NUB_H = 4;      // foam deck: little feet that stop the skirt sealing
                      // flat on it.  The printed deck has none: its guard
                      // prints on the bed, and the fan blows the bag
                      // plastic off it anyway
GUARD_HUB_D = 16;     // printed deck: solid disc where all four quarters
                      // meet, instead of four knife-edged slivers
GUARD_NUB_A = 22.5;   // printed deck: the duct gussets' angles, 22.5 + 45k,
                      // off the seams

// ---------------------------------------------------------------- HS390 cage
// Optional second motor: HS390 (390 size, 12 V, 22 000 rpm, ~28 mm can,
// 2.3 mm shaft).  Its can covers the RS-550 screw holes, so it gets its own
// cage (PART 2b, "fan_cage_hs390"): same grid, same tube, different hub.
// Screw pattern is the Mabuchi 385 datasheet's.  MEASURE YOUR MOTOR.
MOTOR_TYPE  = "RS550";// assembly preview: "RS550" or "HS390"
HS_CAN_D    = 28.0;   // listings say 28; the Mabuchi 385 is 27.7
HS_LEN      = 38;     // can length, preview only
HS_BOLTS    = 16;     // its two tapped holes (M2.6 on the 385)
HS_BOSS_D   = 11.5;   // clears the ~10 mm centring boss.  The counterbores
                      // break into it a little: deliberate, so no knife edge
M25_SNUG    = 2.8;    // M2.5 located by the hole.  If your motor's screws
                      // turn out to be M2.6 (the Mabuchi 385 pattern), set
                      // 2.9: a vertical hole prints ~0.1-0.15 small and 2.8
                      // is an interference fit on an M2.6 major diameter
M25_HEAD_D  = 5;      // counterbore for an M2.5 socket head (4.5 mm)
M25_HEAD_H  = 3.5;    // leaves 2.5 mm under the head: M2.5 x 5 goes 2.5 mm in

// ---------------------------------------------------------------- blower
// Optional fan instead of the propeller: a Delta BFB1212GH centrifugal
// blower (120 x 120 x 32, 12 V, 3.96 A, 4 wires).  It makes ~4x the
// RS-550's pressure but half its flow, so the skirt gets 2 holes, not 6
// (ENGINEERING_CHECK 8.7).  It stands label side down on the deck, its
// inlet (the round face) up, its outlet facing the back.  blower_box
// (with the printed deck, PART 11) is a roof over it and a hood round its outlet that turns the
// air down through a port in the deck; the bdeck_* quarters have that
// port, its guard bars, grooves for the hood walls and screw columns.
// Three Ø4.3 holes on a 105 mm square, at every corner but the outlet's.
// Measured from the photo and the datasheet outline: CHECK YOURS.
BLW_SIZE    = 120;
BLW_H       = 32;
BLW_HOLE_P  = 105;    // hole pitch (square)
BLW_HOLE_D  = 4.3;    // the blower's holes, through its full 32 mm (check)
BLW_HAND    = 1;      // label side down, outlet at the back: +1 if the
                      // corner WITHOUT a hole is at the back RIGHT, -1 if
                      // it is at the back LEFT
BLW_Y       = 17;     // blower centre, ahead of the deck centre: the hood
                      // behind it has to stop short of the nozzle pocket
BLW_GAP     = GRID_OPEN; // blower top to the roof's underside, open all
                      // round: it is the inlet's side opening, so it is a
                      // guard opening too.  Never above 7
BLW_ROOF_T  = 3;
BLW_WALL    = 1.6;    // hood walls (4 lines)
BLW_CLR     = 0.3;    // hood side walls to the blower's sides
BLW_GASKET  = 1.5;    // hood frame to the outlet face: 3 mm foam tape,
                      // squeezed to half
BLW_SEAL    = 2.5;    // how far the frame overlaps the outlet face: the
                      // window is the face less this each side and on top
BLW_SILL_H  = 2.5;    // the window's bottom edge is a sill on the deck: as a
                      // bar on blower_box it would bridge 115 mm
HOOD_D      = 32;     // hood depth behind the frame, outlet to far wall.
                      // Port area ~115 x 27: well over the outlet's
BLW_TUBE_D  = 9;      // standoffs and hood tubes round the M4 screws
BLW_COL_D   = 10;     // deck columns under the screws, bed to skin
BLW_SCREW_L = 50;     // M4 x 50, all five
BLW_GUARD_ZONE = 116; // ring grid in the roof over the inlet

// ---------------------------------------------------------------- the nozzle
NZ_WALL     = 2;
NZ_FLOOR    = 2.4;
NZ_FLANGE   = 10;     // gluing flange round the slot
NZ_IN_X     = 104;    // plenum inside, left to right
NZ_IN_Y     = 40;     // plenum inside, front to back
NZ_IN_Z     = 60;     // plenum inside height
SOCKET_ID   = 50;     // the speed plate socket
SOCKET_WALL = 3;
SOCKET_LEN  = 8;
SOCKET_Z    = 32;     // socket axis height above the deck.  Keep the socket
                      // top (SOCKET_Z + SOCKET_ID/2 + SOCKET_WALL) at least
                      // 1 mm below the roof, NZ_FLOOR + NZ_IN_Z.
SOCKET_SEAT = 5;      // how deep the press fit is
SOCKET_THRU = 48;     // flow hole behind the seat.  The flange is the stop,
                      // so this can be nearly the full socket: a smaller
                      // hole here throttles the fast plates.

// ---------------------------------------------------------------- v2: cards
NOZZLE_V    = 2;      // 2 = drop-in card guide (default), 1 = press-fit socket.
                      // Both are being compared on the track: v1 is printed
                      // and fits well; v2 should be more repeatable.  The
                      // export script writes the v1 set to stl\v1\ as well.
CARD_T      = 2;      // card thickness
CARD_CLEAR  = 0.5;    // slot is this much wider than the card: it must DROP in
CARD_W      = 60;
CARD_HEAD_W = 74;     // the T head, wider than the guide so it is easy to grab
CARD_HEAD_H = 6;      // head height
CARD_HEAD_D = 8;      // head depth: wall face to its outer edge, covers the guide
GUIDE_T     = 2.4;    // the guide's outer plate
GUIDE_RAIL  = 3;      // its side rails
GUIDE_H     = 57;     // guide height above the floor (the roof is at 62.4)
EXIT_D      = 46;     // hole in the back wall and the outer plate.  The card's
                      // hole must stay inside it: cards up to 42 mm, which
                      // covers a 6 s card for any MAGIC up to 252.

// ---------------------------------------------------------------- speed plates
// The boss goes PLATE_BOSS_T - PLATE_FLANGE_T deep into the seat.  Air
// pressure pushes the plate OUT, so the fit is what seals it: a loose plate
// leaks round its flange and the drift-test "zero" plate is not zero.
// Print the plate_test set first and adjust PLATE_FIT until a plate pushes
// in firmly by hand and stays put when the fan runs.
PLATE_FIT      = 0.1;   // bigger number = looser.  A horizontal printed
                        // bore already comes out 0.2 to 0.4 mm small.
PLATE_OD       = SOCKET_ID - PLATE_FIT;
PLATE_BOSS_T   = 6;     // 2 mm flange + 4 mm in the seat
PLATE_LEAD     = 0.6;   // chamfer on the nose of the boss
PLATE_FLANGE_D = 60;
PLATE_FLANGE_T = 2;
PLATE_TAB_W    = 26;
PLATE_TAB_H    = 20;
PLATE_TAB_Y    = 36;
PLATE_TEXT_D   = 0.6;   // number is cut INTO the back face, readable from
                        // behind the craft once the plate is in

// ---------------------------------------------------------------- plate rack
RACK_N       = 13;      // slots.  States and Nationals use 0.5 s steps:
RACK_STEP    = 1;       // set RACK_STEP = 0.5 and print two racks, one with
RACK_T0      = 6;       // RACK_T0 = 6 and one with RACK_T0 = 12.5
RACK_SLOT_W  = (NOZZLE_V == 2) ? CARD_T + 1.2 : 7.2;
RACK_FIN_T   = (NOZZLE_V == 2) ? 1.6 : 2;
RACK_PITCH   = (NOZZLE_V == 2) ? CARD_HEAD_D + 2.2      // cards: the 8 mm heads
                               : RACK_SLOT_W + RACK_FIN_T; // sit side by side
RACK_FIN_H   = (NOZZLE_V == 2) ? 18 : 24;
RACK_DEPTH   = 62;      // the plates are 60 mm across the flange
RACK_LABEL   = 15;
RACK_BASE_T  = 2.4;

// ---------------------------------------------------------------- calibration chart
// The chart must be IMPOUNDED to be used on the floor (rule 2a: nothing
// comes in after impound), so it is a PLA tablet, not paper.  One column
// per surface: the lesson from plywood state tracks is that a smooth-floor
// calibration is useless on wood — each surface gets its own magic number.
// Run 2 needs no chart at all: d2 = d1 x t1 / TT (engraved in the footer).
CHART_MAGICS = [["SMOOTH", MAGIC], ["WOOD", MAGIC]]; // [name, magic] per
                       // surface.  Measure the wood number at a practice
                       // session and update it here; reprint both copies.
CHART_REV    = "A";    // bump when a magic changes, so stale charts get binned
CHART_T0     = 6;      // first row's target time (s)
CHART_T1     = 18;     // last row
CHART_STEP   = 1;      // 0.5 also fits: 25 rows stays under the bed assert
CHART_COL0   = 18;     // TT label column width
CHART_COL    = 28;     // width of one surface column
CHART_ROW    = 9;      // row pitch
CHART_MARGIN = 6;
CHART_TAB_T  = 2.4;    // tablet thickness
CHART_TEXT_D = 0.6;    // engraved like PLATE_TEXT_D; stroke >= 0.5 at size 5
CHART_CELL_S = 5;      // cell text size
RACK_AUX_LABELS = ["0", "15mm", "22mm", "30mm"]; // match the card heads
                       // exactly ("15" would read as a TT-15 speed card)

// ---------------------------------------------------------------- nickel trays
// A bank roll of nickels is 21.6 to 22.5 mm across and 80 to 85 mm long
// with its crimped ends.  Slots are cut oversize on purpose; test them with
// the real rolls from the bank.
ROLL_D      = 21;
SLOT_ROLL_W = 23;
SLOT_ROLL_L = 86;
SLOT_HALF_L = 50;     // coin bin: half roll, 39 mm of coins plus the crimps
TRAY_WALL   = 2.4;
TRAY_FLOOR  = 2;
TRAY_WALL_H = 14;     // the rules say nothing may fall off.  Keep 12 or more.
TRAY_LIGHTEN= true;   // holes in the floor save weight; lighter floats better

// ---------------------------------------------------------------- nickel retention
// Rough plywood tracks shake cargo loose.  Rule 4j: ANYTHING falling off is
// a x0.8 construction penalty, and fallen nickels stop scoring (7f.iv).
// Rule 4g bans tape/adhesive ON the nickels; rigid snap-on retainers are
// legal.  A 22.5 mm roll tops out 8.5 mm above the 14 mm tray walls and can
// pivot an end over the wall at ~9.5 degrees of tilt; a bar whose underside
// is at RET_UNDER caps the rise at ~3 mm.  The loose-20 slot is shortened
// (SLOT_LOOSE_L) and covered by a windowed lid; dimple recesses in the
// tray/bin outer walls give the snap legs a real detent (friction-only
// clips fail a shake test).
NICKEL_D     = 21.2;   // US nickel: 21.21 x 1.95 mm
NICKEL_T     = 1.95;
ROLL_D_MAX   = 22.5;   // fattest crimped bank roll seen
SLOT_LOOSE_L = 41;     // 20 x 1.95 = 39 mm of coins + 2 play (was SLOT_HALF_L:
                       // 11 mm of slop let the on-edge coins fan and climb)
RET_UNDER    = TRAY_FLOOR + ROLL_D_MAX + 0.5;  // 25.0: bar & lid underside
RET_LEG_T    = 1.6;    // snap legs; 0.7 flex over ~17 mm = ~0.6% strain, PLA-safe
RET_LEG_FIT  = 0.15;   // leg inner face off the wall outer face
RET_NUB      = 0.85;   // nub stand-off; 0.7 engagement after RET_LEG_FIT
RET_NUB_H    = 4;      // nub: 45 deg lead-in below, 80 deg hold face above
RET_DIMPLE_D = 1.05;   // recess depth in the tray/bin outer walls
RET_DIMPLE_H = 4.1;    // shrink to 3.9 if a retainer rattles vertically
RET_SNAP_Z   = 8;      // nub/dimple centre height (deck pocket rim ends at 1.5)
BAR_W        = 10;     // tray bar width (= dimple width - 0.4: locates it in Y)
BAR_T        = 2.4;    // bridge plate
BAR_LEG_END  = 4;      // legs stop this far above the tray bottom
LID_T        = 1.2;
LID_RIM_T    = 1.6;    // rims that seat on the bin wall tops
LID_LEG_W    = 12;
LID_WIN_D    = 12;     // < NICKEL_D: a nickel cannot pass a window

// ---------------------------------------------------------------- timing stick
// Rule 3e: the dowel must be within 3 cm of the craft's front edge, and the
// front edge is the SKIRT, not the deck.  So the tower hangs out past the
// deck edge by STAND_OVERHANG.
DOWEL_D     = 6.35;   // 1/4 inch.  Many "1/4 inch" dowels are really 6.0 to
                      // 6.3 mm: measure yours, or the stick will wobble.
DOWEL_FIT   = 0.5;    // loose on purpose: a vertical printed hole comes out
                      // 0.2 to 0.3 mm small, and a true 6.35 dowel must
                      // still drop in.  The set screw takes up the slack.
TOWER_D     = 16;
TOWER_H     = 38;
STAND_X     = 46;
STAND_Y     = 36;     // the part of the base that sits on the deck
STAND_T     = 3;
STAND_OVERHANG = 12;  // dowel axis this far past the deck's front edge
STAND_NECK  = 32;     // the arm is narrower than the base where it crosses
STAND_STOP  = 4;      // the deck edge: the pocket keeps a shoulder 4 deep x
                      // 7 wide each side of it, so the stand can't slide
                      // forward off the deck (it was held by glue alone).
                      // 32 clears the +-40 deg ribs where they cross.

// ---------------------------------------------------------------- switch
// DaierTek 30 A toggle: 12.2 mm panel hole, M12 bushing, body about
// 28 x 16 mm and 30 mm deep behind the panel, two 6.3 mm spade tabs.
SW_HOLE     = 12.8;   // 12.2 mm bushing; a horizontal printed hole comes
                      // out 0.3 to 0.4 mm small
SW_FACE_W   = 34;
SW_FACE_H   = 36;
SW_FACE_T   = 3;
SW_HOLE_Z   = 22;     // body bottom ends up 14 mm above the deck
SW_BASE_D   = 30;     // glue flange under the body
SW_BASE_T   = 3;

// ---------------------------------------------------------------- battery mounts
// The first build taped the holders down with foam tape; on a rough track
// that is a x0.8 "something fell off" waiting to happen.  These are GLUE-ON
// frames — nothing may pierce the deck skin, it is the air cushion's lid —
// aligned by eye to the engraved outline boxes (deck_marks_2d).  Holders
// count as "wires" (rule 3b) and stay on the craft at impound: the cells
// lift out.  A strip of foam tape INSIDE each frame preloads the holder up
// into the hooks: located by the fence, damped by the tape, zero rattle.
// Side walls stay low so every cell label is visible (rule 3f-ii).
BATT_FIT      = 0.3;   // per side: drop-in; the tape preload takes the slack
BATT_WALL     = 1.6;
BATT_FENCE_H  = 6;     // 10 mm below the holder rim: labels stay readable
BATT_FLANGE   = 5;     // glue flange width.  NONE on the +Y side of the
                       // aa4_mount: the switch bracket base is 1.6 mm away
BATT_FLANGE_T = 1.2;
BATT_LIP      = 2;     // fixed lip tabs over the rear rim, 45 deg under-chamfer
BATT_LIP_W    = 12;
BATT_NOTCH_W  = 12;    // wire notch in the rear wall (the 18 AWG exits)
BATT_FOAM     = 0.8;   // the 1 mm foam strip at ~20% crush.  Hooks and lips
                       // sit at AA4_H + BATT_FOAM: they can close over the
                       // rim AND the foam still preloads the holder up
BATT_ARM_TIP  = 10;    // +Y snap arms: SIDEWAYS cantilevers in the wall
BATT_ARM_ROOT = 27;    // plane, rooted outboard (|x| = ROOT..wall end),
BATT_ARM_T    = 1.2;   // free tip toward the middle.  Flex bends the blade
BATT_ARM_Z    = 15;    // about a vertical axis — in-plane, never across
                       // layer adhesion (the tray_bar rule).  strain =
                       // 3*d*t/(2*L^2) = 3 x 1.0 x 1.2 / (2 x 14.5^2)
                       // ~ 0.9% vs 3-5% in-plane PLA break: 3x margin
BATT_HOOK     = 1.0;   // (cells lift out from the top; the arms only
                       // move when the holder itself comes out)
TRIM_TRAVEL   = 30;    // aa2 tray: +/-15 mm of front/back trim for the 2xAA
TRIM_PITCH    = 5;     // fence stations; log the station on the chart card
TRIM_SLOT_W   = 2.0;
TRIM_SLOT_D   = 1.0;
TRIM_FIT      = 0.15;  // fence tab vs station groove (crush ribs take it up)
WCLIP_N       = 6;
WCLIP_W       = 8;     // channel: two 3.5 mm 18 AWG wires side by side
WCLIP_H       = 4;


/* ==========================================================================
   SHARED HELPERS
   ========================================================================== */

// Concentric ring openings, GRID_OPEN wide, tied together by spokes.  About
// 67% open, against 45% for a square mesh, and a 9.5 mm rod still cannot
// get through a 6.5 mm slot.  Returns the OPENINGS (what gets cut away):
// a t-thick cutter whose top edges are chamfered GRID_CHAMF into the rings.
function grid_ring_starts(zone_d, hub_d) =
    [for (r = [hub_d / 2 + GRID_RING : GRID_OPEN + GRID_RING : zone_d / 2 - 1]) r];

module ring_slot(r1, r2, t, c) {                 // one opening, chamfered on top
    rotate_extrude()
        polygon([[r1, -EPS], [r2, -EPS], [r2, t - c],
                 [r2 + c + EPS, t + EPS], [r1 - c - EPS, t + EPS], [r1, t - c]]);
}

module ring_grid_cut(zone_d, hub_d, t) {
    c = GRID_CHAMF;
    difference() {
        for (r = grid_ring_starts(zone_d, hub_d))
            ring_slot(r, min(r + GRID_OPEN, zone_d / 2), t, c);
        for (a = [0 : 360 / GRID_SPOKES : 359])
            rotate(a) translate([0, -GRID_BAR / 2, -1])
                cube([zone_d / 2 + 2, GRID_BAR, t + 2]);
    }
}

// A disc with ring openings between hub_d and zone_d.  Everything outside
// zone_d stays solid (that is the screw rim) and everything inside hub_d
// stays solid (that is where the motor bolts on).
module grid_plate(od, zone_d, t, hub_d = 0) {
    difference() {
        cylinder(d = od, h = t);
        ring_grid_cut(zone_d, hub_d, t);
    }
}

// The cage's bellmouth, as an (r, z) profile with z = 0 on the cage's top
// face: a quarter-circle INLET_R from the bore wall (vertical tangent at the
// throat) outward, INLET_T thick, with a 45 degree underside and a vertical
// foot onto the rim right over the duct wall.
function inlet_foot_h() = sqrt(2) * (INLET_R - INLET_T) - INLET_R + INLET_T;
module inlet_lip_2d() {
    r0 = TUBE_BORE / 2;
    union() {
        intersection() {
            translate([r0 + INLET_R, 0]) circle(r = INLET_R);
            translate([r0, 0]) square([INLET_R, INLET_R]);
            translate([r0 + INLET_R, 0]) rotate(135)
                translate([INLET_R - INLET_T, -2 * INLET_R]) square([INLET_R, 4 * INLET_R]);
        }
        intersection() {                        // foot, its inner face on the arc
            translate([r0 + INLET_R, 0]) circle(r = INLET_R);
            translate([r0, -EPS]) square([INLET_T, inlet_foot_h() + 2 * EPS]);
        }
    }
}

module bore(d, h, z = 0) {
    translate([0, 0, z - EPS]) cylinder(d = d, h = h + 2 * EPS);
}

// Rounded rectangle, corner at the origin unless centred.
module rrect(size, r = 3, center = false) {
    translate(center ? [-size[0] / 2, -size[1] / 2] : [0, 0])
        offset(r = r) offset(delta = -r) square(size);
}

module raised_text(txt, size, h = 0.8) {
    linear_extrude(h)
        text(txt, size = size, halign = "center", valign = "center");
}


/* ==========================================================================
   PART 1 — FAN TUBE  (FOAM-BOARD DECK ONLY)
   The printed deck has this duct built into its four quarters (PART 11);
   print this one only for a foam deck.  Glues over the 13 cm hole.  Prints
   flange down, no supports.  Glue it with hot glue or silicone all the way
   round the flange: air that escapes here never reaches the skirt.
   ========================================================================== */
module fan_tube() {
    shroud_od = TUBE_BORE + 2 * TUBE_WALL;

    difference() {
        union() {
            // gluing flange
            linear_extrude(FLANGE_T, convexity = 4)
                difference() {
                    circle(d = FLANGE_OD);
                    circle(d = TUBE_BORE);
                }
            // shroud
            linear_extrude(TUBE_H, convexity = 4)
                difference() {
                    circle(d = shroud_od);
                    circle(d = TUBE_BORE);
                }
            // screw lugs for the cage.  Each one sits on a thin rib with a
            // 45 degree cone under it, so it prints without an overhang and
            // without the weight of a solid column.  LUG_PHASE keeps this
            // legacy tube bolt-compatible with the re-phased cage.
            for (i = [0 : LUG_N - 1])
                rotate(LUG_PHASE + i * 360 / LUG_N) {
                    translate([LUG_R, 0, TUBE_H - LUG_H - 3])
                        cylinder(d = LUG_D, h = LUG_H + 3);
                    translate([LUG_R, 0, TUBE_H - LUG_H - 3 - LUG_D / 2 + EPS])
                        cylinder(d1 = 0, d2 = LUG_D, h = LUG_D / 2);
                    translate([TUBE_BORE / 2 + TUBE_WALL - EPS, -1.2, FLANGE_T - EPS])
                        cube([LUG_R + LUG_D / 2 - TUBE_BORE / 2 - TUBE_WALL,
                              2.4, TUBE_H - LUG_H - 3 - FLANGE_T + 2 * EPS]);
                }
            // gussets, flange to shroud
            for (a = [0 : 45 : 359])
                rotate(a)
                    translate([shroud_od / 2 - EPS, 0, FLANGE_T - EPS])
                        rotate([90, 0, 0])
                            linear_extrude(2.4, center = true)
                                polygon([[0, 0], [10, 0], [0, 14]]);
        }
        // cage screw holes, with an M3 nut trap in the top of each lug.
        // The cage covers the nuts so they cannot fall out, and the threads
        // are steel: the cage comes off for every propeller change without
        // wearing anything.  (Self-tapped PLA strips after a few cycles.)
        for (i = [0 : LUG_N - 1])
            rotate(LUG_PHASE + i * 360 / LUG_N)
                translate([LUG_R, 0, 0]) {
                    bore(M3_CLEAR, LUG_H + EPS, TUBE_H - LUG_H);
                    translate([0, 0, TUBE_H - NUT_T])
                        cylinder(d = NUT_AF / cos(30), h = NUT_T + EPS, $fn = 6);
                }
    }
}


/* ==========================================================================
   PART 2 — FAN CAGE
   The top guard, and the thing the motor bolts to.  Prints flat, hub up.
   4 walls, 40% infill: it carries a 200 g motor that shakes.
   The two motor screws go in from underneath into counterbores, so their
   heads sit flush with the cage and nothing hangs down toward the prop.

   PART 2b — "fan_cage_hs390": the same cage with a hub for the HS390
   (two M2.5 x 5 screws, 16 mm apart).  Print the one for the motor you fly;
   the tube, the lugs and everything else are shared.
   ========================================================================== */
// The arguments describe the motor face; the defaults are the RS-550.
// vent_a is the half-angle of the vent windows: wide enough to breathe,
// narrow enough to keep a wall beside the screw counterbores.
module fan_cage(bolts = MOTOR_BOLTS, boss_d = MOTOR_BOSS_D, can_d = MOTOR_CAN_D,
                screw_d = M3_SNUG, head_d = M3_HEAD_D, head_h = M3_HEAD_H,
                vent_a = 16) {
    difference() {
        union() {
            grid_plate(CAGE_OD, CAGE_ZONE, CAGE_T, HUB_OD);
            cylinder(d = HUB_OD, h = HUB_T);
            translate([0, 0, CAGE_T - EPS])                     // bellmouth
                rotate_extrude() inlet_lip_2d();
        }
        bore(boss_d, HUB_T);                                    // boss + shaft
        for (s = [-1, 1])                                       // motor screws
            translate([s * bolts / 2, 0, 0]) {
                bore(screw_d, HUB_T);
                bore(head_d, head_h);                           // head, underneath
            }
        // windows under the motor's face vents, so it can breathe.  They sit
        // inside the motor's own footprint (the can covers them) and are
        // GRID_OPEN wide radially, so the 9.5 mm rule holds even without it.
        for (a = [45 : 90 : 359])
            rotate(a)
                linear_extrude(HUB_T + 2 * EPS, center = true)
                    intersection() {
                        difference() {
                            circle(r = min(boss_d / 2 + 2 + GRID_OPEN, can_d / 2 - 1));
                            circle(r = boss_d / 2 + 2);
                        }
                        // RS-550: +/-16 degrees keeps 3 mm of wall beside
                        // the counterbores at +/-12.5 mm.  HS390: +/-12
                        // keeps ~2 mm beside the ones at +/-8 mm.
                        polygon([[0, 0], [30 * cos(-vent_a), 30 * sin(-vent_a)],
                                 [30, 0], [30 * cos(vent_a), 30 * sin(vent_a)]]);
                    }
        for (i = [0 : LUG_N - 1])                               // onto the tube
            rotate(LUG_PHASE + i * 360 / LUG_N)
                translate([LUG_R, 0, 0]) {
                    bore(M3_CLEAR, CAGE_T);
                    bore(INLET_ACC_D, INLET_R + 1, CAGE_T);     // through the flare
                }
    }
}


module fan_cage_hs390() {
    fan_cage(HS_BOLTS, HS_BOSS_D, HS_CAN_D, M25_SNUG, M25_HEAD_D, M25_HEAD_H,
             vent_a = 12);
}


/* ==========================================================================
   PART 3 — FAN GUARD  (the one teams forget — FOAM-BOARD DECK ONLY)
   The printed deck has this grid built into its four quarters (PART 11);
   print this one only for a foam deck.  Glues to the UNDERSIDE of the
   deck, over the 13 cm hole, inside the bag.  It stops the skirt plastic
   being sucked into the propeller.  Prints flat, nubs up; glue the nub
   side towards the skirt.
   ========================================================================== */
module fan_guard() {
    grid_plate(GUARD_OD, GUARD_ZONE, GUARD_T);
    for (a = [0 : 45 : 359])                    // feet that hold the bag off
        rotate(a) translate([GRID_RING / 2 + 7 * (GRID_OPEN + GRID_RING), 0, GUARD_T - EPS])
            cylinder(d = 5, h = GUARD_NUB_H);
}


/* ==========================================================================
   PART 4 — NOZZLE
   An airtight box over the 3 x 10 cm slot.  Air from the squashed skirt comes
   up through the slot, fills the box and leaves straight backwards through a
   hole in the back wall.  The speed card / plate sets the size of that hole.
   Print flange down.

   v2 (NOZZLE_V = 2, the default): a CARD GUIDE on the back wall.  The card
   drops in from the top and bag pressure pushes it flat against the guide's
   outer plate, so the pressure makes the seal and the fit does not matter.
   No supports.  Swap cards in two seconds.

   v1 (NOZZLE_V = 1): the workshop's press-fit socket.  The seal is the fit
   of the plate's boss in the seat, so every plate must feel the same going
   in.  Needs supports everywhere (the roof of the 50 mm seat).
   ========================================================================== */
function nz_out_x() = NZ_IN_X + 2 * NZ_WALL;
function nz_out_y() = NZ_IN_Y + 2 * NZ_WALL;
function nz_wall_y() = -nz_out_y() / 2;          // outer face of the back wall
function guide_d()   = CARD_T + CARD_CLEAR + GUIDE_T; // card guide, wall to outer face

// the box itself: flange, floor, walls, roof, deck slot.  Shared by v1 and v2.
module nz_box() {
    ox = nz_out_x();
    oy = nz_out_y();
    difference() {
        union() {
            linear_extrude(NZ_FLOOR)                                   // flange + floor
                rrect([ox + 2 * NZ_FLANGE, oy + 2 * NZ_FLANGE], 4, center = true);
            translate([0, 0, NZ_FLOOR])                                // walls
                linear_extrude(NZ_IN_Z + NZ_WALL, convexity = 4)
                    difference() {
                        rrect([ox, oy], 3, center = true);
                        rrect([NZ_IN_X, NZ_IN_Y], 2, center = true);
                    }
            translate([0, 0, NZ_FLOOR + NZ_IN_Z])                      // roof
                linear_extrude(NZ_WALL) rrect([ox, oy], 3, center = true);
        }
        translate([0, 0, -EPS])                                        // the deck slot
            linear_extrude(NZ_FLOOR + 2 * EPS)
                rrect([SLOT_X, SLOT_Y], 2, center = true);
    }
}

module nozzle_v2() {
    wall_y = nz_wall_y();
    slot   = CARD_T + CARD_CLEAR;
    gw     = CARD_W + 1 + 2 * GUIDE_RAIL;       // guide outer width
    gd     = guide_d();

    difference() {
        union() {
            nz_box();
            // the card guide: a U channel on the back wall, open at the top
            translate([-gw / 2, wall_y - gd, NZ_FLOOR - EPS])
                cube([gw, gd + EPS, GUIDE_H + EPS]);
        }
        // the slot the card drops into.  Its floor is the nozzle floor.
        translate([-(CARD_W + 1) / 2, wall_y - slot, NZ_FLOOR])
            cube([CARD_W + 1, slot + EPS, GUIDE_H + 1]);
        // exit hole through the back wall and the guide's outer plate.  A
        // round horizontal hole sags at the crown and a sag on the guide
        // plate pokes into the slot and jams the card, so the top of the
        // hole is a 45 degree roof with a short flat bridge instead.
        translate([0, wall_y + NZ_WALL + EPS, SOCKET_Z]) rotate([90, 0, 0])
            linear_extrude(NZ_WALL + gd + 2 * EPS, convexity = 2)
                union() {
                    circle(d = EXIT_D);
                    t = EXIT_D / 2 * sin(45);              // 45 degree tangent point
                    polygon([[-t, t], [t, t], [t - (EXIT_D / 2 + 1 - t), EXIT_D / 2 + 1],
                             [-(t - (EXIT_D / 2 + 1 - t)), EXIT_D / 2 + 1]]);
                }
    }
}

module nozzle_v1() {
    oy        = nz_out_y();
    socket_od = SOCKET_ID + 2 * SOCKET_WALL;
    face_y    = -(oy / 2 + SOCKET_LEN);     // outer face of the socket
    wall_y    = nz_wall_y();

    difference() {
        union() {
            nz_box();
            // socket, filled solid down to the flange so its outside has no
            // overhang at all (overlaps the wall by half its thickness)
            hull() {
                translate([0, wall_y + NZ_WALL / 2, SOCKET_Z]) rotate([90, 0, 0])
                    cylinder(d = socket_od, h = SOCKET_LEN + NZ_WALL / 2);
                translate([-socket_od / 2, face_y, 0])
                    cube([socket_od, SOCKET_LEN + NZ_WALL / 2, NZ_FLOOR]);
            }
        }
        // press fit seat for the speed plate
        translate([0, face_y - EPS, SOCKET_Z]) rotate([-90, 0, 0])
            cylinder(d = SOCKET_ID + 0.2, h = SOCKET_SEAT + EPS);
        // flow hole behind the seat
        translate([0, face_y + SOCKET_SEAT, SOCKET_Z]) rotate([-90, 0, 0])
            cylinder(d = SOCKET_THRU, h = SOCKET_LEN + NZ_WALL + 2 * EPS);
    }
}

module nozzle() { if (NOZZLE_V == 2) nozzle_v2(); else nozzle_v1(); }


/* ==========================================================================
   PART 5a — SPEED CARD  (for nozzle v2)
   A flat card with the hole in it and a T head on top.  The head is the
   datum: it sits on top of the guide, so every card hangs at the same height
   and the hole is always inside the 44 mm exit.  Pressure presses the card
   against the guide's outer plate; the head covers the mouth of the slot.
   Prints lying on its face, head sticking up, no supports.  The number is
   cut into the top of the head so it reads while the card is in.
   ========================================================================== */
module card(hole_d = 22, label = "12") {
    body_h = GUIDE_H - 0.5;                              // never bottoms out
    hole_y = body_h - (NZ_FLOOR + GUIDE_H - SOCKET_Z);   // hole on the exit axis
    size   = (len(label) > 2) ? 4 : 5;
    assert(hole_d <= EXIT_D - 4,
           str("Card ", label, " needs a ", hole_d,
               " mm hole, bigger than the exit.  Raise EXIT_D."));
    difference() {
        union() {
            linear_extrude(CARD_T) rrect([CARD_W, body_h + EPS], 2, center = false);
            translate([(CARD_W - CARD_HEAD_W) / 2, body_h, 0])      // the head
                cube([CARD_HEAD_W, CARD_HEAD_H, CARD_HEAD_D]);
        }
        if (hole_d > 0)
            translate([CARD_W / 2, hole_y, 0]) bore(hole_d, CARD_T);
        // the number, cut into the top face of the head
        translate([CARD_W / 2, body_h + CARD_HEAD_H + EPS, CARD_HEAD_D / 2])
            rotate([90, 0, 0])
                linear_extrude(PLATE_TEXT_D + EPS)
                    text(label, size = size, halign = "center", valign = "center");
    }
}


/* ==========================================================================
   PART 5 — SPEED PLATES
   Big hole = more air = faster.  Small hole = slower.
   The flange stops the plate going in too far and gives you something to pull
   on; the tab carries the number.  Prints flange down, number up, no supports.
   ========================================================================== */
// Tenths of a millimetre: a whole millimetre is 7% of the slow plates'
// hole, about 1.4 s at 18 s, and 17 s and 17.5 s would print the same.
function plate_hole(t) = round(10 * MAGIC / t) / 10;
function plate_label(t) = (t == floor(t)) ? str(floor(t)) : str(t);
// same rounding, any magic: the chart must print exactly what a card drills
function chart_hole(m, t) = round(10 * m / t) / 10;
// "24.2", always one decimal, no float noise ("24.199999")
function fmt1(x) = str(floor(round(10 * x) / 10), ".", round(10 * x) % 10);

module plate_flange_2d() {
    hull() {
        circle(d = PLATE_FLANGE_D);
        translate([0, PLATE_TAB_Y]) rrect([PLATE_TAB_W, PLATE_TAB_H], 4, center = true);
    }
}

module speed_plate(hole_d = 22, label = "12") {
    size = (len(label) > 2) ? 6 : 10;
    assert(hole_d <= SOCKET_THRU - 4,
           str("Plate ", label, " needs a ", hole_d,
               " mm hole, bigger than the nozzle lets through.  Raise SOCKET_THRU."));
    difference() {
        union() {
            linear_extrude(PLATE_FLANGE_T) plate_flange_2d();
            cylinder(d = PLATE_OD, h = PLATE_BOSS_T - PLATE_LEAD);
            translate([0, 0, PLATE_BOSS_T - PLATE_LEAD - EPS])            // lead-in
                cylinder(d1 = PLATE_OD, d2 = PLATE_OD - 2 * PLATE_LEAD,
                         h = PLATE_LEAD + EPS);
        }
        if (hole_d > 0) bore(hole_d, PLATE_BOSS_T);
        // the number, mirrored and cut into the bed face
        translate([0, PLATE_TAB_Y, -EPS])
            linear_extrude(PLATE_TEXT_D + EPS)
                mirror([1, 0])
                    text(label, size = size, halign = "center", valign = "center");
    }
}

// One orifice part of whichever kind the nozzle takes.
module orifice(hole_d, label) {
    if (NOZZLE_V == 2) card(hole_d, label); else speed_plate(hole_d, label);
}

// Lay a list of target times out on the bed (2 columns of cards or 3 of
// plates fit a 220 mm bed).
module orifice_set(times) {
    cols    = (NOZZLE_V == 2) ? 2 : 3;
    pitch_x = (NOZZLE_V == 2) ? CARD_HEAD_W + 6 : PLATE_FLANGE_D + 6;
    pitch_y = (NOZZLE_V == 2) ? GUIDE_H + CARD_HEAD_H + 6
                              : PLATE_FLANGE_D / 2 + PLATE_TAB_Y + PLATE_TAB_H / 2 + 6;
    for (i = [0 : len(times) - 1])
        translate([(i % cols) * pitch_x, -floor(i / cols) * pitch_y, 0])
            orifice(plate_hole(times[i]), plate_label(times[i]));
}

// Step 8b: time these three, then work out your magic number.
module orifice_test() {
    cols    = (NOZZLE_V == 2) ? 2 : 3;
    pitch_x = (NOZZLE_V == 2) ? CARD_HEAD_W + 6 : PLATE_FLANGE_D + 6;
    pitch_y = (NOZZLE_V == 2) ? GUIDE_H + CARD_HEAD_H + 6 : PLATE_FLANGE_D + PLATE_TAB_Y;
    for (i = [0 : 2])
        translate([(i % cols) * pitch_x, -floor(i / cols) * pitch_y, 0])
            orifice([15, 22, 30][i], str([15, 22, 30][i], "mm"));
}


/* ==========================================================================
   PART 6 — PLATE RACK
   Goes into impound with the craft as spare parts, so the plates cannot get
   mixed up.  Numbers read from above.  Prints flat, no supports.
   ========================================================================== */
// labels = undef: the speed-card rack, numbered RACK_T0 upward (unchanged).
// labels = a list: the same rack with those labels and as many slots —
// rack_aux below uses it for the zero + test cards.
module plate_rack(labels = undef) {
    pair  = (NOZZLE_V == 2);      // cards: a pair of thin fins per slot, spaced
                                  // so the heads sit side by side above them
    n     = is_undef(labels) ? RACK_N : len(labels);
    pitch = RACK_PITCH;
    span  = RACK_FIN_T + RACK_SLOT_W + (pair ? RACK_FIN_T : 0);
    off   = pair ? (pitch - span) / 2 : 0;
    len_x = pair ? n * pitch : n * pitch + RACK_FIN_T;
    dep_y = RACK_DEPTH + RACK_LABEL;

    // base
    linear_extrude(RACK_BASE_T) rrect([len_x, dep_y], 4);
    // fins and numbers
    for (i = [0 : n - 1]) {
        x     = i * pitch + off;
        label = is_undef(labels) ? plate_label(RACK_T0 + i * RACK_STEP)
                                 : labels[i];
        translate([x, RACK_LABEL, RACK_BASE_T - EPS])
            cube([RACK_FIN_T, RACK_DEPTH, RACK_FIN_H]);
        if (pair)
            translate([x + RACK_FIN_T + RACK_SLOT_W, RACK_LABEL, RACK_BASE_T - EPS])
                cube([RACK_FIN_T, RACK_DEPTH, RACK_FIN_H]);
        translate([x + RACK_FIN_T + RACK_SLOT_W / 2, RACK_LABEL / 2, RACK_BASE_T - EPS])
            raised_text(label, pair ? ((len(label) > 2) ? 3.5 : 5)
                                    : ((len(label) > 2) ? 4 : 6), 0.8 + EPS);
    }
    if (!pair)                    // plates: one shared fin closes the last slot
        translate([n * pitch, RACK_LABEL, RACK_BASE_T - EPS])
            cube([RACK_FIN_T, RACK_DEPTH, RACK_FIN_H]);
}

// the zero card and the three calibration cards get their own rack, so the
// whole card family goes to impound sorted and nothing rides loose
module rack_aux() { plate_rack(RACK_AUX_LABELS); }


/* ==========================================================================
   PART 6b — CALIBRATION CHART
   An engraved PLA tablet of hole size against target time, one column per
   surface.  Rule 2a: nothing comes into the track area after impound, so
   the chart goes to impound WITH the craft — paper gets lost or wet, a PLA
   tablet rides in the box.  PRINT TWO (one is a spare; spares are legal
   impound items).  Prints flat; the text is engraved into the TOP face and
   is NOT mirrored, unlike speed_plate, which engraves its bed face.
   ========================================================================== */
module chart_plate() {
    times = [for (t = [CHART_T0 : CHART_STEP : CHART_T1]) t];
    nr    = len(times);
    ns    = len(CHART_MAGICS);
    w     = 2 * CHART_MARGIN + CHART_COL0 + ns * CHART_COL;
    // rows from the top: title, surface names, magics, nr data rows,
    // two footer lines
    h     = 2 * CHART_MARGIN + (nr + 5) * CHART_ROW;
    assert(w <= 250 && h <= 250,
           str("chart_plate is ", w, " x ", h,
               " mm: too big for the bed.  Fewer surfaces or a bigger CHART_STEP."));
    for (s = CHART_MAGICS)
        echo(str("CHART    ", s[0], "  magic ", s[1], "  rev ", CHART_REV,
                 "  (d mm = ", s[1], " / TT)"));

    cx0 = CHART_MARGIN + CHART_COL0 / 2;                        // TT column
    function cxs(j) = CHART_MARGIN + CHART_COL0 + (j + 0.5) * CHART_COL;
    function ry(r)  = h - CHART_MARGIN - (r + 0.5) * CHART_ROW; // row r, top down

    difference() {
        linear_extrude(CHART_TAB_T) rrect([w, h], 3);
        // all the text, cut into the top face
        translate([0, 0, CHART_TAB_T - CHART_TEXT_D])
            linear_extrude(CHART_TEXT_D + EPS) {
                translate([w / 2, ry(0)])
                    text(str("HOVERCRAFT B  rev ", CHART_REV), size = 5,
                         halign = "center", valign = "center");
                translate([cx0, ry(1)])
                    text("TT s", size = CHART_CELL_S,
                         halign = "center", valign = "center");
                translate([cx0, ry(2)])
                    text("d mm", size = CHART_CELL_S,
                         halign = "center", valign = "center");
                for (j = [0 : ns - 1]) {
                    translate([cxs(j), ry(1)])
                        text(CHART_MAGICS[j][0], size = CHART_CELL_S,
                             halign = "center", valign = "center");
                    translate([cxs(j), ry(2)])
                        text(str("M=", CHART_MAGICS[j][1]), size = CHART_CELL_S,
                             halign = "center", valign = "center");
                }
                for (i = [0 : nr - 1]) {
                    translate([cx0, ry(3 + i)])
                        text(plate_label(times[i]), size = CHART_CELL_S,
                             halign = "center", valign = "center");
                    for (j = [0 : ns - 1])
                        translate([cxs(j), ry(3 + i)])
                            text(fmt1(chart_hole(CHART_MAGICS[j][1], times[i])),
                                 size = CHART_CELL_S,
                                 halign = "center", valign = "center");
                }
                translate([w / 2, ry(3 + nr)])
                    text("d (mm) = M / TT", size = CHART_CELL_S,
                         halign = "center", valign = "center");
                translate([w / 2, ry(4 + nr)])
                    text("run2: d2 = d1 x t1 / TT", size = CHART_CELL_S,
                         halign = "center", valign = "center");
            }
        // rules under the header block and above the footer
        for (yy = [ry(2) - CHART_ROW / 2, ry(2 + nr) - CHART_ROW / 2])
            translate([CHART_MARGIN, yy - 0.4, CHART_TAB_T - CHART_TEXT_D])
                cube([w - 2 * CHART_MARGIN, 0.8, CHART_TEXT_D + EPS]);
    }
}


/* ==========================================================================
   PART 7 — NICKEL TRAY   (print TWO; they are symmetrical)
   The rules forbid tape and glue on the nickels and forbid opening the rolls,
   so the walls — and the snap-on retainers below — hold the cargo on.
   ========================================================================== */
// the detent recesses in a tray's or bin's +/-X outer walls that the snap
// legs click into.  Friction-only clips fail a shake test; this is a real
// mechanical catch.  Square top edge = the hold face (a 1 mm internal
// ceiling prints fine); 45-degree chamfer below eases the click.  The
// recess width also locates the retainer in Y, +/-0.2.
module ret_dimples(ox, w = BAR_W + 0.4) {
    for (s = [-1, 1])
        translate([s * ox / 2, 0, RET_SNAP_Z])
            scale([s, 1, 1])                       // local +x points outward
                rotate([90, 0, 0])
                    linear_extrude(w, center = true, convexity = 2)
                        polygon([[ EPS,            RET_DIMPLE_H / 2],
                                 [-RET_DIMPLE_D,   RET_DIMPLE_H / 2],
                                 [-RET_DIMPLE_D,  -RET_DIMPLE_H / 2],
                                 [ EPS,           -RET_DIMPLE_H / 2 - RET_DIMPLE_D]]);
}

// one snap leg with its nub, as a 2D profile: x across the part, y = the
// INSTALLED height.  The caller extrudes it to width.  Leg tip: 45-degree
// lead-in on the inner edge (rides over the wall), 1.5 mm pry flare on the
// outer (thumbnail removal).  Nub: 45-degree lead-in below; the hold face
// above defaults near-square — vertical shake cannot cam it open, a
// deliberate pry can.  That default suits parts printed on their side
// (tray_bar).  A part printed legs-UP must pass hold = RET_NUB: its hold
// face becomes an underside, and anything steeper than 45 degrees there
// is a one-layer overhang that droops into spaghetti.  `t` thins the leg
// for parts whose snap flex runs across layer adhesion (bin_lid).
module ret_leg_2d(xi, z_tip, z_top, hold = 0.15, t = RET_LEG_T) {
    xo = xi + t;
    polygon([[xi + 0.6, z_tip], [xo + 1.5, z_tip], [xo, z_tip + 3],
             [xo, z_top], [xi, z_top], [xi, z_tip + 0.6]]);
    polygon([[xi + EPS,     RET_SNAP_Z - RET_NUB_H / 2],
             [xi - RET_NUB, RET_SNAP_Z - RET_NUB_H / 2 + RET_NUB],
             [xi - RET_NUB, RET_SNAP_Z + RET_NUB_H / 2 - hold],
             [xi + EPS,     RET_SNAP_Z + RET_NUB_H / 2]]);
}

module nickel_tray() {
    ox = 2 * SLOT_ROLL_W + 3 * TRAY_WALL;
    oy = SLOT_ROLL_L + 2 * TRAY_WALL;
    h  = TRAY_FLOOR + TRAY_WALL_H;

    difference() {
        linear_extrude(h) rrect([ox, oy], 3, center = true);

        for (s = [-1, 1]) {
            // the roll slot
            translate([s * (SLOT_ROLL_W + TRAY_WALL) / 2, 0, TRAY_FLOOR])
                linear_extrude(TRAY_WALL_H + EPS)
                    rrect([SLOT_ROLL_W, SLOT_ROLL_L], 2, center = true);
            // floor holes: every gram off the craft is a gram the fan can lift
            if (TRAY_LIGHTEN)
                for (k = [-1, 0, 1])
                    translate([s * (SLOT_ROLL_W + TRAY_WALL) / 2, k * 26, 0])
                        bore(12, TRAY_FLOOR);
            // finger notches in the end walls, so you can lift a roll out
            for (e = [-1, 1])
                translate([s * (SLOT_ROLL_W + TRAY_WALL) / 2, e * oy / 2,
                           TRAY_FLOOR + TRAY_WALL_H])
                    rotate([90, 0, 0])
                        cylinder(d = 14, h = 2 * TRAY_WALL + 2 * EPS, center = true);
        }
        ret_dimples(ox);
    }
}


/* ==========================================================================
   PART 7b — TRAY BAR   (print TWO, one per tray, plus a spare)
   A 22.5 mm roll stands 8.5 mm proud of the 14 mm tray walls: pivoting
   about one end, the rising end clears the wall at ~9.5 degrees of tilt.
   This bar snaps across the tray at mid-span with its underside at
   RET_UNDER, capping the rise at ~3 mm — the roll cannot get out, and the
   end-wall finger notches stay clear (pop the bar, lift rolls as before).
   Drawn in PRINT orientation: lying on its side, layers through the legs,
   so snap flex loads the plastic in-plane, not across layer adhesion.
   ========================================================================== */
module tray_bar() {
    ox = 2 * SLOT_ROLL_W + 3 * TRAY_WALL;      // the tray's outer width
    xi = ox / 2 + RET_LEG_FIT;                 // leg inner face
    xo = xi + RET_LEG_T;
    linear_extrude(BAR_W, convexity = 4) {
        translate([-xo, RET_UNDER]) square([2 * xo, BAR_T]);   // bridge plate
        for (s = [-1, 1]) scale([s, 1])
            ret_leg_2d(xi, BAR_LEG_END, RET_UNDER + EPS);
    }
}


/* ==========================================================================
   PART 8 — COIN BIN
   One slot for the half roll, one for the 20 loose nickels standing on edge.
   The loose slot is cut to the coin stack (SLOT_LOOSE_L): the old shared
   50 mm slot left 11 mm of slop for the coins to fan and climb in.  The
   half-roll slot stays 50 — crimped lengths vary, and a captive roll
   rattling lengthwise costs nothing.  bin_lid below closes the top.
   ========================================================================== */
module coin_bin() {
    ox = 2 * SLOT_ROLL_W + 3 * TRAY_WALL;
    oy = SLOT_HALF_L + 2 * TRAY_WALL;
    h  = TRAY_FLOOR + TRAY_WALL_H;
    labels = ["1/2", "20"];

    difference() {
        union() {
            linear_extrude(h) rrect([ox, oy], 3, center = true);
            for (i = [0, 1])
                translate([(i == 0 ? -1 : 1) * (SLOT_ROLL_W + TRAY_WALL) / 2,
                           -oy / 2 + EPS, h - 7])
                    rotate([90, 0, 0]) raised_text(labels[i], 6, 0.8);
        }
        for (s = [-1, 1])
            translate([s * (SLOT_ROLL_W + TRAY_WALL) / 2, 0, TRAY_FLOOR])
                linear_extrude(TRAY_WALL_H + EPS)
                    rrect([SLOT_ROLL_W, s > 0 ? SLOT_LOOSE_L : SLOT_HALF_L],
                          2, center = true);
        // floor bores like the trays': every gram off is lift margin.  A
        // 21.2 mm coin on edge spans a 10 mm hole with its contact points
        // 10 mm apart — stable.  The bin pocket floor is solid underneath.
        if (TRAY_LIGHTEN)
            for (s = [-1, 1], k = [-1, 1])
                translate([s * (SLOT_ROLL_W + TRAY_WALL) / 2, k * 12, 0])
                    bore(10, TRAY_FLOOR);
        ret_dimples(ox, LID_LEG_W + 0.4);
    }
}


/* ==========================================================================
   PART 8b — BIN LID   (print ONE, plus a spare)
   A snap-on windowed lid over both bin slots: coins stand on edge under a
   ceiling at RET_UNDER with ~1 mm of headroom, so nothing can flip, fan or
   jump.  The six 12 mm windows are smaller than a nickel, so the event
   supervisor counts the cargo through them — or pops the lid in two
   seconds.  Rims seat on the wall tops (no rock); the dimples hold it.
   bin_lid() is the PRINT orientation: plate on the bed, legs up, text
   engraved into the bed face (the fan_guard flip).  bin_lid_installed()
   is what the assembly shows.
   ========================================================================== */
module bin_lid_installed() {
    ox  = 2 * SLOT_ROLL_W + 3 * TRAY_WALL;
    oy  = SLOT_HALF_L + 2 * TRAY_WALL;
    xi  = ox / 2 + RET_LEG_FIT;
    xo  = xi + RET_LEG_T;
    top = RET_UNDER + LID_T;
    wx  = (SLOT_ROLL_W + TRAY_WALL) / 2;        // slot centres, +/-12.7

    difference() {
        union() {
            // plate
            translate([0, 0, RET_UNDER])
                linear_extrude(LID_T) rrect([2 * xo, oy], 3, center = true);
            // side rims, centred over the 2.4 mm side walls
            for (s = [-1, 1])
                translate([s * (ox / 2 - TRAY_WALL / 2) - LID_RIM_T / 2, -23,
                           RET_UNDER - 9])
                    cube([LID_RIM_T, 46, 9 + EPS]);
            // end tabs on the end-wall tops
            for (e = [-1, 1])
                translate([-6, e * (oy / 2 - TRAY_WALL / 2) - LID_RIM_T / 2,
                           RET_UNDER - 9])
                    cube([12, LID_RIM_T, 9 + EPS]);
            // snap legs.  Printed legs-up, so (a) the nub hold face is cut
            // at 45 degrees (hold = RET_NUB) — near-square would be an
            // unprintable one-layer overhang; the dimple ceiling still
            // stops it with ~0.2 mm free play — and (b) the legs are
            // thinned to 1.2 with a root gusset: their flex runs ACROSS
            // layer adhesion, unlike the on-side tray_bar, so this cuts
            // strain to ~0.44% and braces the sharp plate corner where
            // the bending moment peaks
            for (s = [-1, 1])
                scale([s, 1, 1]) rotate([90, 0, 0])
                    linear_extrude(LID_LEG_W, center = true, convexity = 4) {
                        ret_leg_2d(xi, 5.5, RET_UNDER + EPS, RET_NUB, 1.2);
                        polygon([[xi + EPS, RET_UNDER + EPS],
                                 [xi - 2,   RET_UNDER + EPS],
                                 [xi + EPS, RET_UNDER - 2]]);
                    }
        }
        // windows: none passes a nickel, all show the cargo
        for (yy = [-13, 0, 13]) translate([ wx, yy]) bore(LID_WIN_D, LID_T, RET_UNDER);
        for (yy = [-15, 0, 15]) translate([-wx, yy]) bore(LID_WIN_D, LID_T, RET_UNDER);
        // labels, engraved into the top face over each slot
        for (i = [0, 1])
            translate([(i == 0 ? -1 : 1) * wx, 20.5, top - 0.4])
                linear_extrude(0.4 + EPS)
                    text(["1/2", "20"][i], size = 5,
                         halign = "center", valign = "center");
    }
}

module bin_lid() {
    // rotate, NOT mirror: a mirrored model prints the ENANTIOMER — a part
    // that can never be flipped back into the designed shape, with its
    // labels mirror-imaged however you turn it.  rotate([180,0,0]) negates
    // z just the same but is a rigid motion, and it lands the engraving on
    // the bed face already mirror-imaged, which the flip onto the bin undoes.
    translate([0, 0, RET_UNDER + LID_T]) rotate([180, 0, 0]) bin_lid_installed();
}
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
