austiz/Hovercraft/(list of files, cad)

Other CAD files:
stl/fan_cage.stl
