austiz/Hovercraft/(commit log)

2026-10-03 Hovercraft B 2027: OpenSCAD parts, docs, STLs and mockup
    Single-file OpenSCAD library for every printed part of the Hover Racer
    (fan tube, ring cage with the RS-550 bolted to its hub, under-deck guard,
    nozzle v2 with drop-in speed cards plus the v1 press-fit socket, rack,
    nickel trays, coin bin, dowel stand, switch bracket, templates), the
    export script, exported STLs (v2 default, v1 set in stl/v1), rendered
    mockup views, the engineering check (mounting, fasteners, rules, physics)
    and per-part print settings.
    [coin_bin.stl, fan_cage.stl, fan_guard.stl, fan_tube.stl, hovercraft_parts.scad, mockup_assembly.stl, nickel_tray.stl, nozzle.stl]
2026-10-03 Add Bambu Studio CLI slicing, keep v1 nozzle set for comparison
    slice_all.ps1 slices every part for a P1S (0.4 nozzle) at 0.28 mm with
    Bambu PLA Basic on the textured PEI plate, applying the per-part walls,
    infill, supports and brim from PRINT_SETTINGS.md. tools/flatten_preset.js
    resolves Bambu's preset inheritance into standalone JSON, which the CLI
    needs (it ignores "inherits"; a flattened machine preset must keep
    from=system or the slicer rejects it as incompatible).
    Nozzle v2 (cards) stays the default; the printed v1 press-fit set is
    exported to stl/v1 and sliced too, with the comparison protocol in
    ENGINEERING_CHECK.md 3.1. Print settings table covers both.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
2026-10-03 slice_all: fix filament weight parsing, -Only list, arrange, solid infill pattern
    Bambu Studio 2.x renamed the rectilinear infill pattern to zig-zag, so
    the 100% infill card/plate jobs were rejected as invalid parameters.
2026-10-03 Add motor comparison (section 8), motor model, and printed deck quarters
    - ENGINEERING_CHECK 8: three candidate motors (22k, 40k 12 V, smaller
    original) modelled on the 5030 prop and AA pack, test-day protocol,
    decision order, results sheet. tools/motor_model.js runs the model and
    converts a measured prop rpm into lift margin.
    - Printed deck (PART 11): optional four-quarter replacement for the foam
    board, each quarter fits the P1S bed: 2-layer skin with a triangle rib
    grid underneath, 3-layer rib-free edge band, jigsaw tabs, bolted seam
    ribs, engraved outlines showing where every part goes. ~93 g in PLA.
    [deck_bl.stl, deck_br.stl, deck_fl.stl, deck_fr.stl, hovercraft_parts.scad]
2026-10-03 Add HS390 clamp sleeve (PART 12) for the existing fan cage
    - hs390_sleeve: split clamp sleeve that grips the 28 mm can, centres on
    the hub's 2 mm step and zip-ties to four cage spokes. The motor face
    sits on the hub like the RS-550's, so the prop height is unchanged; no
    drilling, no reprint. MOTOR_TYPE = "HS390" shows it in the assembly
    with fit checks.
    - motor_model: HS390 row with the lighter craft (-107 g).
    - ENGINEERING_CHECK 8.6, PRINT_SETTINGS row, export list, hardware.
    [hovercraft_parts.scad, hs390_sleeve.stl]
2026-10-03 Replace HS390 sleeve with a dedicated HS390 fan cage
    - fan_cage() now takes the motor face as arguments (defaults = RS-550,
    output unchanged). fan_cage_hs390 (PART 2b): same grid, rim and lugs,
    hub for 2 x M2.5 x 5 at 16 mm (Mabuchi 385 pattern), 11.5 mm boss bore,
    vents under the 28 mm can. MOTOR_TYPE = "HS390" previews it.
    - Drop the clamp sleeve (PART 12).
    - motor_model: HS390 row with the 119 g lighter craft.
    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
    [fan_cage_hs390.stl, hovercraft_parts.scad, hs390_sleeve.stl]
2026-10-03 Finish the printed deck: bolt seats, scripts, docs
    - Seam bolts moved where no grid rib crosses the head or nut seat
    (4 of 7 were blocked): V = -82, 82, 112; H = +/-90, +/-118. Checked by
    intersecting the rib grid with the seats. Quarters re-exported.
    - Deck quarters added to export_stl.ps1 and slice_all.ps1 (2 walls,
    0.2 first layer, no brim). Sliced: ~40 min and 22-24 g each, 91 g.
    - PRINT_SETTINGS rows, hardware (7x M3x8 + nuts, packing tape), PART
    list, build order; ENGINEERING_CHECK section 9 plus mass and
    structure notes.
    [deck_bl.stl, deck_br.stl, deck_fl.stl, deck_fr.stl, hovercraft_parts.scad]
2026-10-03 Printed deck: press-fit sockets for every printed part
    The deck is the only part not yet printed, so it takes the sockets and
    no printed part changes. Every part presses into a 1.5 mm pocket in the
    deck top (the guard into one underneath the fan ring).
    - Pockets are cut from the parts' own footprints: fan tube ring, guard
    ring below a shared floor, nozzle frame, trays, bin, stand, bracket.
    - The deck prints top face down, so pocket floors are bridges: lips
    beside the ring pocket, a lip round the nozzle slot, pegs through the
    trays' floor holes; bin/stand/bracket bridge plainly (thick bridges).
    - deck_fit_test: three coupons to tune SOCK_FIT on the real parts.
    - Seam ribs 9.5 tall with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
    [deck_bl.stl, deck_br.stl, deck_fit_test.stl, deck_fl.stl, deck_fr.stl, hovercraft_parts.scad]
2026-10-03 Deck joints: drop the centre-joint tab, glue the ribs, tab coupon
    - The jigsaw tab moved onto the centre joint sat in the rib zone, where
    the neighbour's seam rib stands over the slot: a knob can only enter
    straight down, so it could never have been assembled. Removed; the
    stand and nozzle pockets lock that joint. The side-joint pair stays,
    in the band.
    - DECK_TAB_CLR 0.15 -> 0.2 (knob and slot are both first-layer features).
    - deck_fit_test gains both halves of a side-joint tab.
    - Build order: CA/epoxy on the seam rib faces, bolts as the clamp.
    - STLs re-exported, 3MFs re-sliced.
    [deck_bl.stl, deck_br.stl, deck_fit_test.stl, deck_fl.stl, deck_fr.stl, hovercraft_parts.scad]
2026-10-03 Printed deck: engraved skirt tape line on the underside
    One-layer groove 10 mm in from the edge, in the band's underside, where
    the first strip of skirt tape goes. Breaks round the socket pads and the
    jigsaw tabs. Build order notes the step where the tape runs onto the
    nozzle and stand pads.
    [deck_bl.stl, deck_br.stl, deck_fl.stl, deck_fr.stl, hovercraft_parts.scad]
2026-10-03 Printed deck: no single-layer spots
    - Pocket floors 0.48 -> 0.84: on the 0.28 grid a 0.48 bridged floor can
    slice to one porous layer. Now three, the bridge at the bottom.
    - A 0.28 strip under the engraved battery-holder marks: the mark took
    the first layer and left one.
    - Audit of every thin feature on the 0.20/0.28 grid in ENGINEERING_CHECK
    9.1a; tape-underneath fallback in the checks.
    [deck_bl.stl, deck_br.stl, deck_fit_test.stl, deck_fl.stl, deck_fr.stl, hovercraft_parts.scad]
2026-10-03 PRINT_SETTINGS: sliced numbers for the three-layer-floor deck
2026-10-03 Printed deck: three layers everywhere, skirt lip with shock cord
    - DECK_SKIN 0.48 -> 0.76: nothing on the deck is under three layers.
    The tape groove now cuts a 4-layer strip beside it (it had been cut
    into the band, leaving 2); the degenerate band slab is guarded out.
    - Skirt lip (DECK_LIP): 10 mm wall round the underside of the edge,
    3 lines thick, 1.6 mm ridge at the bottom with a stepped chamfer. The
    plastic wraps over it and 1/8" or 3/16" hardware-store shock cord
    pulled tight above the ridge holds and seals it. Rule 3a echo includes
    the ridge (393 x 383). Fit test gains a lip coupon.
    - Verified: single solids, parts clear their pockets, layer audit on the
    0.20/0.28 grid.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
    [deck_bl.stl, deck_br.stl, deck_fit_test.stl, deck_fl.stl, deck_fr.stl, hovercraft_parts.scad]
2026-10-03 Add wear_pad: printed 14 cm foot for the bag (4 layers, chamfered edge)
    [hovercraft_parts.scad, wear_pad.stl]
2026-10-03 wear_pad: three layers, not four
    [hovercraft_parts.scad, wear_pad.stl]
2026-10-03 wear_pad: two layers
    [hovercraft_parts.scad, wear_pad.stl]
2026-10-09 Skirt cap: hem-cord skirt snaps over a crowned deck lip; tooling + docs
    - Printed deck edge is deck_edge_2d(): sides bowed out LIP_CROWN = 5 mm so
    the skirt's hem cord presses on every side (a cord on a straight side
    presses on nothing). Rule 3a/3e unchanged.
    - Skirt is a cap: 48 x 47 cm plastic, shock cord in a taped 2 cm hem,
    stretches over the lip. Build steps, hardware and §9.1b updated.
    - Cage bellmouth, thinner chamfered guard rings (other session).
    - tools/verify.ps1, check_parts.js, mesh_check.js; AGENTS.md (CLAUDE.md
    points to it), SCAD_PRACTICES.md, RECOVERY_PLAN.md, RESEARCH.md,
    .mcp.json, .vscode settings.
    - STLs regenerated; deck quarters re-sliced (73-76 g, 1 h 48-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
    [aa2_fences.stl, aa2_tray.stl, aa4_mount.stl, bin_lid.stl, chart_plate.stl, coin_bin.stl, deck_bl.stl, deck_br.stl]
2026-10-20 Blower deck: bdeck quarters + blower_box for a Delta BFB1212GH; tighter dovetail/tab fit
    [bdeck_bl.stl, bdeck_br.stl, bdeck_fl.stl, bdeck_fr.stl, blower_box.stl, deck_bl.stl, deck_br.stl, deck_fit_test.stl]
